Fawad149/SAR-ADC-sg13g2/digital/librelane/runs/RUN_FINAL/50-odb-reportwirelength/wire_lengths.csv

net | length_um
net33 | 156.355µm
net6 | 126.21µm
net1 | 120.975µm
clknet_0_clk | 112.86µm
_063_ | 108.015µm
net8 | 104.31µm
net14 | 100.2µm
net2 | 96.61µm
net11 | 95.785µm
net3 | 87.08µm
net12 | 79.865µm
clknet_2_2__leaf_clk | 70.425µm
rst | 70.11µm
net15 | 70.105µm
net5 | 68.985µm
net4 | 67.265µm
clknet_2_3__leaf_clk | 65.265µm
clknet_2_0__leaf_clk | 64.51µm
clk | 60.52µm
clknet_2_1__leaf_clk | 56.805µm
net13 | 56.125µm
_055_ | 53.545µm
_051_ | 53.43µm
net9 | 51.06µm
_059_ | 48.95µm
net18 | 45.74µm
net35 | 44.96µm
net17 | 44.37µm
net19 | 39.33µm
_053_ | 39.155µm
net7 | 37.465µm
net30 | 37.11µm
_066_ | 35.355µm
net16 | 35.27µm
dbit\[1\] | 34.965µm
net40 | 34.51µm
_043_ | 33.155µm
net41 | 32.695µm
net36 | 32.005µm
net27 | 31.09µm
net124 | 31.02µm
net24 | 30.745µm
net20 | 30.705µm
net42 | 29.78µm
D[11] | 29.49µm
B[7] | 29.26µm
BN[10] | 28.53µm
dbit\[0\] | 28.03µm
D[8] | 27.39µm
net37 | 27.285µm
net34 | 26.83µm
net29 | 26.77µm
net31 | 26.48µm
B[2] | 25.71µm
_036_ | 25.58µm
D[0] | 25.48µm
net28 | 25.215µm
net25 | 25.1µm
_058_ | 24.68µm
sign | 24.4µm
net53 | 24.32µm
dbit\[2\] | 24.01µm
_054_ | 23.905µm
net45 | 23.89µm
net66 | 23.76µm
_042_ | 23.235µm
net23 | 23.01µm
D[1] | 22.86µm
net38 | 22.825µm
net57 | 22.68µm
dbit\[3\] | 22.68µm
net22 | 22.485µm
net55 | 22.475µm
net92 | 22.435µm
BN[5] | 22.29µm
_030_ | 22.09µm
net84 | 22.09µm
B[10] | 21.81µm
B[8] | 21.72µm
BN[11] | 21.65µm
D[4] | 21.63µm
D[6] | 21.33µm
net103 | 21.12µm
net44 | 21.01µm
B[6] | 20.85µm
net52 | 20.83µm
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
net51 | 3µm
net128 | 3µm
net130 | 3µm
_045_ | 2.76µm
net85 | 2.73µm
_038_ | 2.66µm
net97 | 2.58µm
net102 | 2.18µm
net129 | 2.18µm
_033_ | 1.87µm
_006_ | 1.8µm
_008_ | 1.8µm
_014_ | 1.8µm
_018_ | 1.8µm
_037_ | 1.705µm
net100 | 1.7µm
net115 | 1.44µm
_034_ | 0.98µm
net89 | 0.96µm
net91 | 0.96µm
