Fawad149/SAR-ADC-sg13g2/digital/librelane/runs/RUN_FINAL/56-openroad-irdropreport/net-VGND.csv

Instance | Terminal | Layer | X location | Y location | Voltage
FILLER_17_144 | VSS | Metal1 | 75.8280 | 82.7830 | 0.000008
FILLER_17_137 | VSS | Metal1 | 73.2060 | 82.6990 | 0.000008
FILLER_17_130 | VSS | Metal1 | 69.8460 | 82.6990 | 0.000008
FILLER_17_123 | VSS | Metal1 | 66.4860 | 82.6990 | 0.000008
FILLER_17_117 | VSS | Metal1 | 62.4000 | 83.1600 | 0.000008
FILLER_17_84 | VSS | Metal1 | 46.3200 | 83.1600 | 0.000007
FILLER_17_77 | VSS | Metal1 | 44.4060 | 82.6990 | 0.000007
FILLER_17_70 | VSS | Metal1 | 41.0460 | 82.6990 | 0.000007
FILLER_17_53 | VSS | Metal1 | 31.4400 | 83.1600 | 0.000006
FILLER_17_49 | VSS | Metal1 | 30.2280 | 82.7830 | 0.000006
FILLER_17_42 | VSS | Metal1 | 27.6060 | 82.6990 | 0.000006
FILLER_17_35 | VSS | Metal1 | 24.2460 | 82.6990 | 0.000006
FILLER_17_28 | VSS | Metal1 | 20.8860 | 82.6990 | 0.000006
FILLER_17_21 | VSS | Metal1 | 17.5260 | 82.6990 | 0.000006
FILLER_17_14 | VSS | Metal1 | 14.1660 | 82.6990 | 0.000006
FILLER_17_7 | VSS | Metal1 | 10.8060 | 82.6990 | 0.000006
FILLER_17_0 | VSS | Metal1 | 7.4460 | 82.6990 | 0.000006
FILLER_16_147 | VSS | Metal1 | 76.5600 | 75.6000 | 0.000181
FILLER_16_143 | VSS | Metal1 | 75.3480 | 75.9760 | 0.000181
FILLER_16_136 | VSS | Metal1 | 72.7260 | 76.0600 | 0.000181
FILLER_16_129 | VSS | Metal1 | 69.3660 | 76.0600 | 0.000181
FILLER_16_122 | VSS | Metal1 | 66.0060 | 76.0600 | 0.000181
FILLER_16_88 | VSS | Metal1 | 48.4800 | 75.6000 | 0.000179
FILLER_16_32 | VSS | Metal1 | 21.6000 | 75.6000 | 0.000179
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
B\[2\]$_SDFFE_PP1P_ | VSS | Metal1 | 63.4650 | 67.7470 | 0.000703
B\[1\]$_SDFFE_PP1P_ | VSS | Metal1 | 15.2550 | 52.6270 | 0.000262
B\[11\]$_SDFFE_PP1P_ | VSS | Metal1 | 37.7940 | 60.1260 | 0.000152
B\[10\]$_SDFFE_PP1P_ | VSS | Metal1 | 41.3850 | 75.8920 | 0.000179
B\[0\]$_SDFFE_PP1P_ | VSS | Metal1 | 25.5450 | 15.4120 | 0.000056
BN\[9\]$_SDFFE_PP1P_ | VSS | Metal1 | 15.7350 | 68.3320 | 0.000697
BN\[8\]$_SDFFE_PP1P_ | VSS | Metal1 | 14.7750 | 29.9470 | 0.000478
BN\[7\]$_SDFFE_PP1P_ | VSS | Metal1 | 69.2250 | 52.6270 | 0.000300
BN\[6\]$_SDFFE_PP1P_ | VSS | Metal1 | 54.8250 | 68.3320 | 0.000701
BN\[5\]$_SDFFE_PP1P_ | VSS | Metal1 | 30.3450 | 75.3070 | 0.000178
BN\[4\]$_SDFFE_PP1P_ | VSS | Metal1 | 15.2550 | 45.0670 | 0.000362
BN\[3\]$_SDFFE_PP1P_ | VSS | Metal1 | 68.2650 | 37.5070 | 0.000512
BN\[2\]$_SDFFE_PP1P_ | VSS | Metal1 | 70.1850 | 60.7720 | 0.000193
BN\[1\]$_SDFFE_PP1P_ | VSS | Metal1 | 15.2550 | 53.2120 | 0.000262
BN\[11\]$_SDFFE_PP1P_ | VSS | Metal1 | 62.9850 | 29.9470 | 0.000542
BN\[10\]$_SDFFE_PP1P_ | VSS | Metal1 | 44.2650 | 67.7470 | 0.000701
BN\[0\]$_SDFFE_PP1P_ | VSS | Metal1 | 28.4250 | 22.3870 | 0.000206
