Fawad149/SAR-ADC-sg13g2/digital/librelane/runs/RUN_FINAL/56-openroad-irdropreport/net-VPWR.csv

Instance | Terminal | Layer | X location | Y location | Voltage
FILLER_17_144 | VDD | Metal1 | 75.8510 | 79.9760 | 1.199898
FILLER_17_137 | VDD | Metal1 | 73.2090 | 79.9780 | 1.199898
FILLER_17_130 | VDD | Metal1 | 69.8490 | 79.9780 | 1.199898
FILLER_17_123 | VDD | Metal1 | 66.4890 | 79.9780 | 1.199898
FILLER_17_117 | VDD | Metal1 | 62.4000 | 79.3800 | 1.199898
FILLER_17_84 | VDD | Metal1 | 46.3200 | 79.3800 | 1.199900
FILLER_17_77 | VDD | Metal1 | 44.4090 | 79.9780 | 1.199900
FILLER_17_70 | VDD | Metal1 | 41.0490 | 79.9780 | 1.199900
FILLER_17_53 | VDD | Metal1 | 31.4400 | 79.3800 | 1.199901
FILLER_17_49 | VDD | Metal1 | 30.2510 | 79.9760 | 1.199902
FILLER_17_42 | VDD | Metal1 | 27.6090 | 79.9780 | 1.199929
FILLER_17_35 | VDD | Metal1 | 24.2490 | 79.9780 | 1.199930
FILLER_17_28 | VDD | Metal1 | 20.8890 | 79.9780 | 1.199930
FILLER_17_21 | VDD | Metal1 | 17.5290 | 79.9780 | 1.199936
FILLER_17_14 | VDD | Metal1 | 14.1690 | 79.9780 | 1.199936
FILLER_17_7 | VDD | Metal1 | 10.8090 | 79.9780 | 1.199936
FILLER_17_0 | VDD | Metal1 | 7.4490 | 79.9780 | 1.199936
FILLER_16_147 | VDD | Metal1 | 76.5600 | 79.3800 | 1.199898
FILLER_16_143 | VDD | Metal1 | 75.3710 | 78.7830 | 1.199898
FILLER_16_136 | VDD | Metal1 | 72.7290 | 78.7810 | 1.199898
FILLER_16_129 | VDD | Metal1 | 69.3690 | 78.7810 | 1.199898
FILLER_16_122 | VDD | Metal1 | 66.0090 | 78.7810 | 1.199898
FILLER_16_88 | VDD | Metal1 | 48.4800 | 79.3800 | 1.199899
FILLER_16_32 | VDD | Metal1 | 21.6000 | 79.3800 | 1.199930
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
B\[2\]$_SDFFE_PP1P_ | VDD | Metal1 | 63.6220 | 64.7410 | 1.199568
B\[1\]$_SDFFE_PP1P_ | VDD | Metal1 | 15.0970 | 49.6210 | 1.199613
B\[11\]$_SDFFE_PP1P_ | VDD | Metal1 | 37.3960 | 57.1870 | 1.199766
B\[10\]$_SDFFE_PP1P_ | VDD | Metal1 | 41.5420 | 78.8980 | 1.199900
B\[0\]$_SDFFE_PP1P_ | VDD | Metal1 | 25.7020 | 18.4180 | 1.199833
BN\[9\]$_SDFFE_PP1P_ | VDD | Metal1 | 15.5770 | 71.3380 | 1.199523
BN\[8\]$_SDFFE_PP1P_ | VDD | Metal1 | 14.6170 | 26.9410 | 1.199708
BN\[7\]$_SDFFE_PP1P_ | VDD | Metal1 | 69.3820 | 49.6210 | 1.199562
BN\[6\]$_SDFFE_PP1P_ | VDD | Metal1 | 54.9820 | 71.3380 | 1.199472
BN\[5\]$_SDFFE_PP1P_ | VDD | Metal1 | 30.5020 | 72.3010 | 1.199503
BN\[4\]$_SDFFE_PP1P_ | VDD | Metal1 | 15.0970 | 42.0610 | 1.199733
BN\[3\]$_SDFFE_PP1P_ | VDD | Metal1 | 68.4220 | 34.5010 | 1.199375
BN\[2\]$_SDFFE_PP1P_ | VDD | Metal1 | 70.3420 | 63.7780 | 1.199568
BN\[1\]$_SDFFE_PP1P_ | VDD | Metal1 | 15.0970 | 56.2180 | 1.199769
BN\[11\]$_SDFFE_PP1P_ | VDD | Metal1 | 63.1420 | 26.9410 | 1.199658
BN\[10\]$_SDFFE_PP1P_ | VDD | Metal1 | 44.4220 | 64.7410 | 1.199588
BN\[0\]$_SDFFE_PP1P_ | VDD | Metal1 | 28.5820 | 19.3810 | 1.199833
