Fawad149/SAR-ADC-sg13g2/verification/SAR_ADC_extracted.cir

* Extracted by KLayout with SG13G2 LVS runset on : 11/07/2026 05:27

.SUBCKT SAR_ADC gnd vref vdd clk_cmp vbias D1 D9 D0 clk_samp sign D4 D2 D5 D8
+ D3 D10 D7 D11 D6 Vinn Vinp
X$21 gnd clk_samp vdd Vinn \$211 bootstrap_switch$1
X$24 gnd clk_samp vdd Vinp \$212 bootstrap_switch
X$54 gnd vdd \$4 clk_cmp \$120 \$126 \$127 vbias dynamic_comparator_new
X$59 \$13 \$12 \$9 \$6 \$3 \$26 vref \$91 \$89 \$87 \$92 \$88 \$90 \$120 cdac$2
X$78 \$22 \$18 \$11 \$10 \$5 \$35 vref \$82 \$81 \$80 \$85 \$84 \$83 \$4 cdac
X$100 gnd \$17 D1 \$127 \$126 vdd \$23 \$20 \$14 clk_cmp \$98 \$49 \$58 D0
+ clk_samp sign D4 \$71 D9 D8 \$21 \$19 \$8 D5 \$99 \$45 \$60 D2 \$16 D3 \$15
+ D10 \$42 \$43 \$41 D7 D6 \$7 \$206 \$76 \$72 \$24 D11 sar_logic
X$112 \$7 \$8 \$14 \$15 \$16 \$23 gnd vref \$26 \$13 \$12 \$9 \$6 \$3 vdd \$71
+ \$72 \$42 \$98 \$99 \$41 \$92 \$88 \$90 \$91 \$89 \$87 switch_array_new$2
X$128 \$24 \$21 \$20 \$19 \$45 \$17 gnd vref \$35 \$22 \$18 \$11 \$10 \$5 vdd
+ \$58 \$206 \$43 \$49 \$60 \$76 \$85 \$84 \$83 \$82 \$81 \$80 switch_array_new
.ENDS SAR_ADC

.SUBCKT switch_array_new D5 D4 D3 D2 D1 D0 gnd Vref S5 S4 S3 S2 S1 S0 vdd D_MSB
+ D10 D9 D8 D7 D6 S_MSB S10 S9 S8 S7 S6
M$1 Vref D5 S5 gnd sg13_lv_nmos L=0.13u W=2u AS=0.68p AD=0.68p PS=4.68u PD=4.68u
M$2 Vref D4 S4 gnd sg13_lv_nmos L=0.13u W=2u AS=0.68p AD=0.68p PS=4.68u PD=4.68u
M$3 Vref D3 S3 gnd sg13_lv_nmos L=0.13u W=2u AS=0.68p AD=0.68p PS=4.68u PD=4.68u
M$4 Vref D2 S2 gnd sg13_lv_nmos L=0.13u W=2u AS=0.68p AD=0.68p PS=4.68u PD=4.68u
M$5 Vref D1 S1 gnd sg13_lv_nmos L=0.13u W=2u AS=0.68p AD=0.68p PS=4.68u PD=4.68u
M$6 Vref D0 S0 gnd sg13_lv_nmos L=0.13u W=2u AS=0.68p AD=0.68p PS=4.68u PD=4.68u
M$7 gnd \$110 S7 gnd sg13_lv_nmos L=0.13u W=2u AS=0.68p AD=0.68p PS=4.68u
+ PD=4.68u
M$8 gnd \$109 S8 gnd sg13_lv_nmos L=0.13u W=2u AS=0.68p AD=0.68p PS=4.68u
+ PD=4.68u
M$9 gnd \$108 S9 gnd sg13_lv_nmos L=0.13u W=2u AS=0.68p AD=0.68p PS=4.68u
+ PD=4.68u
M$10 gnd \$111 S6 gnd sg13_lv_nmos L=0.13u W=2u AS=0.68p AD=0.68p PS=4.68u
+ PD=4.68u
M$11 gnd \$25 S2 gnd sg13_lv_nmos L=0.13u W=2u AS=0.68p AD=0.68p PS=4.68u
+ PD=4.68u
M$12 gnd \$23 S4 gnd sg13_lv_nmos L=0.13u W=2u AS=0.68p AD=0.68p PS=4.68u
+ PD=4.68u
M$13 gnd \$21 S5 gnd sg13_lv_nmos L=0.13u W=2u AS=0.68p AD=0.68p PS=4.68u
+ PD=4.68u
M$14 gnd \$24 S3 gnd sg13_lv_nmos L=0.13u W=2u AS=0.68p AD=0.68p PS=4.68u
+ PD=4.68u
M$15 gnd \$106 S_MSB gnd sg13_lv_nmos L=0.13u W=2u AS=0.68p AD=0.68p PS=4.68u
+ PD=4.68u
M$16 gnd \$26 S1 gnd sg13_lv_nmos L=0.13u W=2u AS=0.68p AD=0.68p PS=4.68u
+ PD=4.68u
M$17 gnd \$107 S10 gnd sg13_lv_nmos L=0.13u W=2u AS=0.68p AD=0.68p PS=4.68u
+ PD=4.68u
M$18 gnd \$27 S0 gnd sg13_lv_nmos L=0.13u W=2u AS=0.68p AD=0.68p PS=4.68u
+ PD=4.68u
M$19 Vref D6 S6 gnd sg13_lv_nmos L=0.13u W=2u AS=0.68p AD=0.68p PS=4.68u
+ PD=4.68u
M$20 Vref D7 S7 gnd sg13_lv_nmos L=0.13u W=2u AS=0.68p AD=0.68p PS=4.68u
+ PD=4.68u
M$21 Vref D8 S8 gnd sg13_lv_nmos L=0.13u W=2u AS=0.68p AD=0.68p PS=4.68u
+ PD=4.68u
M$22 Vref D9 S9 gnd sg13_lv_nmos L=0.13u W=2u AS=0.68p AD=0.68p PS=4.68u
+ PD=4.68u
M$23 Vref D10 S10 gnd sg13_lv_nmos L=0.13u W=2u AS=0.68p AD=0.68p PS=4.68u
+ PD=4.68u
M$24 Vref D_MSB S_MSB gnd sg13_lv_nmos L=0.13u W=2u AS=0.68p AD=0.68p PS=4.68u
+ PD=4.68u
M$25 gnd D5 S5 vdd sg13_lv_pmos L=0.13u W=4u AS=1.36p AD=1.36p PS=8.68u PD=8.68u
M$26 gnd D4 S4 vdd sg13_lv_pmos L=0.13u W=4u AS=1.36p AD=1.36p PS=8.68u PD=8.68u
M$27 gnd D3 S3 vdd sg13_lv_pmos L=0.13u W=4u AS=1.36p AD=1.36p PS=8.68u PD=8.68u
M$28 gnd D2 S2 vdd sg13_lv_pmos L=0.13u W=4u AS=1.36p AD=1.36p PS=8.68u PD=8.68u
M$29 gnd D1 S1 vdd sg13_lv_pmos L=0.13u W=4u AS=1.36p AD=1.36p PS=8.68u PD=8.68u
M$30 gnd D0 S0 vdd sg13_lv_pmos L=0.13u W=4u AS=1.36p AD=1.36p PS=8.68u PD=8.68u
M$31 gnd D7 S7 vdd sg13_lv_pmos L=0.13u W=4u AS=1.36p AD=1.36p PS=8.68u PD=8.68u
M$32 gnd D8 S8 vdd sg13_lv_pmos L=0.13u W=4u AS=1.36p AD=1.36p PS=8.68u PD=8.68u
M$33 gnd D6 S6 vdd sg13_lv_pmos L=0.13u W=4u AS=1.36p AD=1.36p PS=8.68u PD=8.68u
M$34 gnd D9 S9 vdd sg13_lv_pmos L=0.13u W=4u AS=1.36p AD=1.36p PS=8.68u PD=8.68u
M$35 gnd D10 S10 vdd sg13_lv_pmos L=0.13u W=4u AS=1.36p AD=1.36p PS=8.68u
+ PD=8.68u
M$36 gnd D_MSB S_MSB vdd sg13_lv_pmos L=0.13u W=4u AS=1.36p AD=1.36p PS=8.68u
+ PD=8.68u
M$37 Vref \$21 S5 vdd sg13_lv_pmos L=0.13u W=4u AS=1.36p AD=1.36p PS=8.68u
+ PD=8.68u
M$38 Vref \$24 S3 vdd sg13_lv_pmos L=0.13u W=4u AS=1.36p AD=1.36p PS=8.68u
+ PD=8.68u
M$39 Vref \$26 S1 vdd sg13_lv_pmos L=0.13u W=4u AS=1.36p AD=1.36p PS=8.68u
+ PD=8.68u
M$40 Vref \$27 S0 vdd sg13_lv_pmos L=0.13u W=4u AS=1.36p AD=1.36p PS=8.68u
+ PD=8.68u
M$41 Vref \$110 S7 vdd sg13_lv_pmos L=0.13u W=4u AS=1.36p AD=1.36p PS=8.68u
+ PD=8.68u
M$42 Vref \$107 S10 vdd sg13_lv_pmos L=0.13u W=4u AS=1.36p AD=1.36p PS=8.68u
+ PD=8.68u
M$43 Vref \$106 S_MSB vdd sg13_lv_pmos L=0.13u W=4u AS=1.36p AD=1.36p PS=8.68u
+ PD=8.68u
M$44 Vref \$108 S9 vdd sg13_lv_pmos L=0.13u W=4u AS=1.36p AD=1.36p PS=8.68u
+ PD=8.68u
M$45 Vref \$109 S8 vdd sg13_lv_pmos L=0.13u W=4u AS=1.36p AD=1.36p PS=8.68u
+ PD=8.68u
M$46 Vref \$111 S6 vdd sg13_lv_pmos L=0.13u W=4u AS=1.36p AD=1.36p PS=8.68u
+ PD=8.68u
M$47 Vref \$25 S2 vdd sg13_lv_pmos L=0.13u W=4u AS=1.36p AD=1.36p PS=8.68u
+ PD=8.68u
M$48 Vref \$23 S4 vdd sg13_lv_pmos L=0.13u W=4u AS=1.36p AD=1.36p PS=8.68u
+ PD=8.68u
M$49 gnd D5 \$21 gnd sg13_lv_nmos L=0.13u W=0.4u AS=0.136p AD=0.136p PS=1.48u
+ PD=1.48u
M$50 gnd D4 \$23 gnd sg13_lv_nmos L=0.13u W=0.4u AS=0.136p AD=0.136p PS=1.48u
+ PD=1.48u
M$51 gnd D3 \$24 gnd sg13_lv_nmos L=0.13u W=0.4u AS=0.136p AD=0.136p PS=1.48u
+ PD=1.48u
M$52 gnd D2 \$25 gnd sg13_lv_nmos L=0.13u W=0.4u AS=0.136p AD=0.136p PS=1.48u
+ PD=1.48u
M$53 gnd D1 \$26 gnd sg13_lv_nmos L=0.13u W=0.4u AS=0.136p AD=0.136p PS=1.48u
+ PD=1.48u
M$54 gnd D0 \$27 gnd sg13_lv_nmos L=0.13u W=0.4u AS=0.136p AD=0.136p PS=1.48u
+ PD=1.48u
M$55 gnd D6 \$111 gnd sg13_lv_nmos L=0.13u W=0.4u AS=0.136p AD=0.136p PS=1.48u
+ PD=1.48u
M$56 gnd D9 \$108 gnd sg13_lv_nmos L=0.13u W=0.4u AS=0.136p AD=0.136p PS=1.48u
+ PD=1.48u
M$57 gnd D7 \$110 gnd sg13_lv_nmos L=0.13u W=0.4u AS=0.136p AD=0.136p PS=1.48u
+ PD=1.48u
M$58 gnd D_MSB \$106 gnd sg13_lv_nmos L=0.13u W=0.4u AS=0.136p AD=0.136p
+ PS=1.48u PD=1.48u
M$59 gnd D10 \$107 gnd sg13_lv_nmos L=0.13u W=0.4u AS=0.136p AD=0.136p PS=1.48u
+ PD=1.48u
M$60 gnd D8 \$109 gnd sg13_lv_nmos L=0.13u W=0.4u AS=0.136p AD=0.136p PS=1.48u
+ PD=1.48u
M$61 vdd D5 \$21 vdd sg13_lv_pmos L=0.13u W=0.8u AS=0.272p AD=0.272p PS=2.28u
+ PD=2.28u
M$62 vdd D4 \$23 vdd sg13_lv_pmos L=0.13u W=0.8u AS=0.272p AD=0.272p PS=2.28u
+ PD=2.28u
M$63 vdd D3 \$24 vdd sg13_lv_pmos L=0.13u W=0.8u AS=0.272p AD=0.272p PS=2.28u
+ PD=2.28u
M$64 vdd D2 \$25 vdd sg13_lv_pmos L=0.13u W=0.8u AS=0.272p AD=0.272p PS=2.28u
+ PD=2.28u
M$65 vdd D1 \$26 vdd sg13_lv_pmos L=0.13u W=0.8u AS=0.272p AD=0.272p PS=2.28u
+ PD=2.28u
M$66 vdd D0 \$27 vdd sg13_lv_pmos L=0.13u W=0.8u AS=0.272p AD=0.272p PS=2.28u
+ PD=2.28u
M$67 vdd D6 \$111 vdd sg13_lv_pmos L=0.13u W=0.8u AS=0.272p AD=0.272p PS=2.28u
+ PD=2.28u
M$68 vdd D7 \$110 vdd sg13_lv_pmos L=0.13u W=0.8u AS=0.272p AD=0.272p PS=2.28u
+ PD=2.28u
M$69 vdd D8 \$109 vdd sg13_lv_pmos L=0.13u W=0.8u AS=0.272p AD=0.272p PS=2.28u
+ PD=2.28u
M$70 vdd D9 \$108 vdd sg13_lv_pmos L=0.13u W=0.8u AS=0.272p AD=0.272p PS=2.28u
+ PD=2.28u
M$71 vdd D10 \$107 vdd sg13_lv_pmos L=0.13u W=0.8u AS=0.272p AD=0.272p PS=2.28u
+ PD=2.28u
M$72 vdd D_MSB \$106 vdd sg13_lv_pmos L=0.13u W=0.8u AS=0.272p AD=0.272p
+ PS=2.28u PD=2.28u
.ENDS switch_array_new

.SUBCKT dynamic_comparator_new gnd vdd Vplus clk Vminus out_plus out_minus vbias
R$1 \$4 gnd rppd w=2.5u l=18.02u ps=0.18u b=6 m=1
R$2 gnd \$6 rppd w=2.5u l=18.02u ps=0.18u b=6 m=1
M$3 \$22 Vminus \$4 vdd sg13_lv_pmos L=0.3u W=8u AS=2.72p AD=2.72p PS=16.68u
+ PD=16.68u
M$4 \$6 Vplus \$22 vdd sg13_lv_pmos L=0.3u W=8u AS=2.72p AD=2.72p PS=16.68u
+ PD=16.68u
M$5 vdd vbias \$22 vdd sg13_lv_pmos L=0.8u W=12u AS=4.08p AD=4.08p PS=24.68u
+ PD=24.68u
M$6 \$10 \$6 \$5 vdd sg13_lv_pmos L=0.3u W=32u AS=7.28p AD=7.28p PS=41.82u
+ PD=41.82u
M$10 \$10 \$4 \$13 vdd sg13_lv_pmos L=0.3u W=32u AS=7.28p AD=7.28p PS=41.82u
+ PD=41.82u
M$14 out_minus \$5 vdd vdd sg13_lv_pmos L=0.2u W=8u AS=2.72p AD=2.72p PS=16.68u
+ PD=16.68u
M$15 out_plus \$13 vdd vdd sg13_lv_pmos L=0.2u W=8u AS=2.72p AD=2.72p PS=16.68u
+ PD=16.68u
M$16 \$13 \$5 gnd gnd sg13_lv_nmos L=0.2u W=4u AS=1.36p AD=1.36p PS=8.68u
+ PD=8.68u
M$17 \$5 clk gnd gnd sg13_lv_nmos L=0.2u W=4u AS=1.36p AD=1.36p PS=8.68u
+ PD=8.68u
M$18 \$5 \$13 gnd gnd sg13_lv_nmos L=0.2u W=4u AS=1.36p AD=1.36p PS=8.68u
+ PD=8.68u
M$19 \$13 clk gnd gnd sg13_lv_nmos L=0.2u W=4u AS=1.36p AD=1.36p PS=8.68u
+ PD=8.68u
M$20 gnd \$13 out_plus gnd sg13_lv_nmos L=0.2u W=4u AS=1.36p AD=1.36p PS=8.68u
+ PD=8.68u
M$21 gnd \$5 out_minus gnd sg13_lv_nmos L=0.2u W=4u AS=1.36p AD=1.36p PS=8.68u
+ PD=8.68u
M$22 vdd vbias \$43 vdd sg13_lv_pmos L=0.3u W=18u AS=4.095p AD=4.095p PS=24.32u
+ PD=24.32u
M$26 \$43 clk \$10 vdd sg13_lv_pmos L=0.3u W=18u AS=4.095p AD=4.095p PS=24.32u
+ PD=24.32u
.ENDS dynamic_comparator_new

.SUBCKT bootstrap_switch gnd clk vdd vi vo
M$1 gnd \$3 \$29 gnd sg13_lv_nmos L=0.2u W=1.3u AS=0.442p AD=0.442p PS=3.28u
+ PD=3.28u
M$2 \$15 vdd \$23 gnd sg13_lv_nmos L=0.13u W=3u AS=1.02p AD=1.02p PS=6.68u
+ PD=6.68u
M$3 \$15 \$3 gnd gnd sg13_lv_nmos L=0.13u W=3u AS=1.02p AD=1.02p PS=6.68u
+ PD=6.68u
M$4 vi \$23 \$29 gnd sg13_lv_nmos L=0.25u W=3.5u AS=1.19p AD=1.19p PS=7.68u
+ PD=7.68u
M$5 vi \$3 vi gnd sg13_lv_nmos L=0.13u W=1.5u AS=0.51p AD=0.51p PS=3.68u
+ PD=3.68u
M$6 vo \$3 vo gnd sg13_lv_nmos L=0.13u W=1.5u AS=0.51p AD=0.51p PS=3.68u
+ PD=3.68u
M$7 vo \$25 vi gnd sg13_lv_nmos L=0.25u W=6u AS=2.04p AD=2.04p PS=12.68u
+ PD=12.68u
M$8 vdd \$18 \$19 gnd sg13_lv_nmos L=0.13u W=1.3u AS=0.442p AD=0.442p PS=3.28u
+ PD=3.28u
M$9 vdd \$19 \$22 gnd sg13_lv_nmos L=0.13u W=1.3u AS=0.442p AD=0.442p PS=3.28u
+ PD=3.28u
M$10 vdd \$19 \$18 gnd sg13_lv_nmos L=0.13u W=1.3u AS=0.442p AD=0.442p PS=3.28u
+ PD=3.28u
C$11 \$22 \$29 cap_cmim w=11.485u l=11.485u A=131.905225p P=45.94u m=1
C$12 \$19 \$3 cap_cmim w=4.665u l=6.99u A=32.60835p P=23.31u m=1
C$13 \$18 \$12 cap_cmim w=4.665u l=6.99u A=32.60835p P=23.31u m=1
M$14 \$23 \$35 vdd vdd sg13_lv_pmos L=0.13u W=0.5u AS=0.17p AD=0.17p PS=1.68u
+ PD=1.68u
M$15 \$22 \$50 \$25 \$22 sg13_lv_pmos L=0.13u W=0.5u AS=0.17p AD=0.17p PS=1.68u
+ PD=1.68u
M$16 \$36 \$3 gnd gnd sg13_lv_nmos L=0.13u W=0.5u AS=0.17p AD=0.17p PS=1.68u
+ PD=1.68u
M$17 \$25 vdd \$36 gnd sg13_lv_nmos L=0.13u W=0.5u AS=0.17p AD=0.17p PS=1.68u
+ PD=1.68u
M$18 vdd clk \$3 vdd sg13_lv_pmos L=0.13u W=0.8u AS=0.272p AD=0.272p PS=2.28u
+ PD=2.28u
M$19 vdd \$35 \$50 vdd sg13_lv_pmos L=0.13u W=0.8u AS=0.272p AD=0.272p PS=2.28u
+ PD=2.28u
M$20 vdd \$3 \$12 vdd sg13_lv_pmos L=0.13u W=0.8u AS=0.272p AD=0.272p PS=2.28u
+ PD=2.28u
M$21 gnd clk \$3 gnd sg13_lv_nmos L=0.13u W=0.4u AS=0.136p AD=0.136p PS=1.48u
+ PD=1.48u
M$22 gnd \$3 \$12 gnd sg13_lv_nmos L=0.13u W=0.4u AS=0.136p AD=0.136p PS=1.48u
+ PD=1.48u
M$23 gnd \$35 \$50 gnd sg13_lv_nmos L=0.13u W=0.4u AS=0.136p AD=0.136p PS=1.48u
+ PD=1.48u
.ENDS bootstrap_switch

.SUBCKT bootstrap_switch$1 gnd clk vdd vi vo
M$1 gnd \$3 \$29 gnd sg13_lv_nmos L=0.2u W=1.3u AS=0.442p AD=0.442p PS=3.28u
+ PD=3.28u
M$2 \$15 vdd \$23 gnd sg13_lv_nmos L=0.13u W=3u AS=1.02p AD=1.02p PS=6.68u
+ PD=6.68u
M$3 \$15 \$3 gnd gnd sg13_lv_nmos L=0.13u W=3u AS=1.02p AD=1.02p PS=6.68u
+ PD=6.68u
M$4 vi \$23 \$29 gnd sg13_lv_nmos L=0.25u W=3.5u AS=1.19p AD=1.19p PS=7.68u
+ PD=7.68u
M$5 vi \$3 vi gnd sg13_lv_nmos L=0.13u W=1.5u AS=0.51p AD=0.51p PS=3.68u
+ PD=3.68u
M$6 vo \$3 vo gnd sg13_lv_nmos L=0.13u W=1.5u AS=0.51p AD=0.51p PS=3.68u
+ PD=3.68u
M$7 vo \$25 vi gnd sg13_lv_nmos L=0.25u W=6u AS=2.04p AD=2.04p PS=12.68u
+ PD=12.68u
M$8 vdd \$18 \$19 gnd sg13_lv_nmos L=0.13u W=1.3u AS=0.442p AD=0.442p PS=3.28u
+ PD=3.28u
M$9 vdd \$19 \$22 gnd sg13_lv_nmos L=0.13u W=1.3u AS=0.442p AD=0.442p PS=3.28u
+ PD=3.28u
M$10 vdd \$19 \$18 gnd sg13_lv_nmos L=0.13u W=1.3u AS=0.442p AD=0.442p PS=3.28u
+ PD=3.28u
C$11 \$22 \$29 cap_cmim w=11.485u l=11.485u A=131.905225p P=45.94u m=1
C$12 \$19 \$3 cap_cmim w=4.665u l=6.99u A=32.60835p P=23.31u m=1
C$13 \$18 \$12 cap_cmim w=4.665u l=6.99u A=32.60835p P=23.31u m=1
M$14 \$23 \$35 vdd vdd sg13_lv_pmos L=0.13u W=0.5u AS=0.17p AD=0.17p PS=1.68u
+ PD=1.68u
M$15 \$22 \$50 \$25 \$22 sg13_lv_pmos L=0.13u W=0.5u AS=0.17p AD=0.17p PS=1.68u
+ PD=1.68u
M$16 \$36 \$3 gnd gnd sg13_lv_nmos L=0.13u W=0.5u AS=0.17p AD=0.17p PS=1.68u
+ PD=1.68u
M$17 \$25 vdd \$36 gnd sg13_lv_nmos L=0.13u W=0.5u AS=0.17p AD=0.17p PS=1.68u
+ PD=1.68u
M$18 vdd clk \$3 vdd sg13_lv_pmos L=0.13u W=0.8u AS=0.272p AD=0.272p PS=2.28u
+ PD=2.28u
M$19 vdd \$35 \$50 vdd sg13_lv_pmos L=0.13u W=0.8u AS=0.272p AD=0.272p PS=2.28u
+ PD=2.28u
M$20 vdd \$3 \$12 vdd sg13_lv_pmos L=0.13u W=0.8u AS=0.272p AD=0.272p PS=2.28u
+ PD=2.28u
M$21 gnd clk \$3 gnd sg13_lv_nmos L=0.13u W=0.4u AS=0.136p AD=0.136p PS=1.48u
+ PD=1.48u
M$22 gnd \$3 \$12 gnd sg13_lv_nmos L=0.13u W=0.4u AS=0.136p AD=0.136p PS=1.48u
+ PD=1.48u
M$23 gnd \$35 \$50 gnd sg13_lv_nmos L=0.13u W=0.4u AS=0.136p AD=0.136p PS=1.48u
+ PD=1.48u
.ENDS bootstrap_switch$1

.SUBCKT sar_logic VGND B[0] D[1] Om Op VPWR BN[0] B[3] BN[3] clk BN[8] B[8]
+ B[11] D[0] rst sign D[4] BN[11] D[9] D[8] B[4] B[2] BN[4] D[5] BN[7] B[1]
+ B[7] D[2] BN[1] D[3] BN[2] D[10] BN[9] B[9] BN[6] D[7] D[6] BN[5] B[10] B[6]
+ BN[10] B[5] D[11]
M$1 \$I4110 \$198 VGND VGND sg13_lv_nmos L=0.13u W=0.55u AS=0.187p AD=0.1045p
+ PS=1.78u PD=0.93u
M$2 VGND \$63 \$I4110 VGND sg13_lv_nmos L=0.13u W=0.55u AS=0.1045p AD=0.198p
+ PS=0.93u PD=1.27u
M$3 \$I4110 \$228 VGND VGND sg13_lv_nmos L=0.13u W=0.55u AS=0.198p AD=0.13395p
+ PS=1.27u PD=1.12u
M$4 VGND \$I4110 \$230 VGND sg13_lv_nmos L=0.13u W=0.74u AS=0.13395p AD=0.2516p
+ PS=1.12u PD=2.16u
M$5 \$I4110 \$198 \$I4112 VPWR sg13_lv_pmos L=0.13u W=1u AS=0.34p AD=0.19p
+ PS=2.68u PD=1.38u
M$6 \$I4112 \$63 \$I4111 VPWR sg13_lv_pmos L=0.13u W=1u AS=0.19p AD=0.1575p
+ PS=1.38u PD=1.315u
M$7 \$I4111 \$228 VPWR VPWR sg13_lv_pmos L=0.13u W=1u AS=0.1575p AD=0.3822p
+ PS=1.315u PD=1.84u
M$8 VPWR \$I4110 \$230 VPWR sg13_lv_pmos L=0.13u W=1.12u AS=0.3822p AD=0.3808p
+ PS=1.84u PD=2.92u
M$9 VGND \$90 \$I4113 VGND sg13_lv_nmos L=0.13u W=0.55u AS=0.187p AD=0.1045p
+ PS=1.78u PD=0.93u
M$10 \$I4113 \$64 VGND VGND sg13_lv_nmos L=0.13u W=0.55u AS=0.1045p AD=0.1469p
+ PS=0.93u PD=1.155u
M$11 VGND \$I4113 \$94 VGND sg13_lv_nmos L=0.13u W=0.74u AS=0.1469p AD=0.2516p
+ PS=1.155u PD=2.16u
M$12 \$I4113 \$90 \$I4114 VPWR sg13_lv_pmos L=0.13u W=0.84u AS=0.2856p
+ AD=0.1596p PS=2.36u PD=1.22u
M$13 VPWR \$64 \$I4114 VPWR sg13_lv_pmos L=0.13u W=0.84u AS=0.2226p AD=0.1596p
+ PS=1.535u PD=1.22u
M$14 VPWR \$I4113 \$94 VPWR sg13_lv_pmos L=0.13u W=1.12u AS=0.2226p AD=0.3976p
+ PS=1.535u PD=2.95u
M$15 VGND \$195 \$I4115 VGND sg13_lv_nmos L=0.13u W=0.55u AS=0.187p AD=0.1045p
+ PS=1.78u PD=0.93u
M$16 \$I4115 \$43 VGND VGND sg13_lv_nmos L=0.13u W=0.55u AS=0.1045p AD=0.1469p
+ PS=0.93u PD=1.155u
M$17 VGND \$I4115 \$228 VGND sg13_lv_nmos L=0.13u W=0.74u AS=0.1469p AD=0.2516p
+ PS=1.155u PD=2.16u
M$18 \$I4115 \$195 \$I4116 VPWR sg13_lv_pmos L=0.13u W=0.84u AS=0.2856p
+ AD=0.1596p PS=2.36u PD=1.22u
M$19 VPWR \$43 \$I4116 VPWR sg13_lv_pmos L=0.13u W=0.84u AS=0.2226p AD=0.1596p
+ PS=1.535u PD=1.22u
M$20 VPWR \$I4115 \$228 VPWR sg13_lv_pmos L=0.13u W=1.12u AS=0.2226p AD=0.3976p
+ PS=1.535u PD=2.95u
M$21 VGND \$18 \$431 VGND sg13_lv_nmos L=0.13u W=1.48u AS=0.3922p AD=0.2812p
+ PS=3.28u PD=2.24u
M$23 VGND \$317 \$431 VGND sg13_lv_nmos L=0.13u W=1.48u AS=0.2812p AD=0.3922p
+ PS=2.24u PD=3.28u
M$25 \$I4117 \$18 VPWR VPWR sg13_lv_pmos L=0.13u W=2.24u AS=0.616p AD=0.4256p
+ PS=4.46u PD=3u
M$27 \$I4117 \$317 \$431 VPWR sg13_lv_pmos L=0.13u W=2.24u AS=0.4256p
+ AD=0.5936p PS=3u PD=4.42u
M$29 VGND \$43 \$136 VGND sg13_lv_nmos L=0.13u W=1.48u AS=0.3922p AD=0.2812p
+ PS=3.28u PD=2.24u
M$31 VGND \$195 \$136 VGND sg13_lv_nmos L=0.13u W=1.48u AS=0.2812p AD=0.3922p
+ PS=2.24u PD=3.28u
M$33 \$I4118 \$43 VPWR VPWR sg13_lv_pmos L=0.13u W=2.24u AS=0.616p AD=0.4256p
+ PS=4.46u PD=3u
M$35 \$I4118 \$195 \$136 VPWR sg13_lv_pmos L=0.13u W=2.24u AS=0.4256p
+ AD=0.5936p PS=3u PD=4.42u
M$37 VGND \$I4120 \$I4119 VGND sg13_lv_nmos L=0.5u W=0.42u AS=0.1426p
+ AD=0.1428p PS=1.16u PD=1.52u
M$38 VGND \$I4119 \$84 VGND sg13_lv_nmos L=0.13u W=0.74u AS=0.1426p AD=0.2516p
+ PS=1.16u PD=2.16u
M$39 \$I4121 \$18 VGND VGND sg13_lv_nmos L=0.13u W=0.42u AS=0.1428p AD=0.0798p
+ PS=1.52u PD=0.8u
M$40 VGND \$I4121 \$I4120 VGND sg13_lv_nmos L=0.5u W=0.42u AS=0.0798p
+ AD=0.1428p PS=0.8u PD=1.52u
M$41 \$I4119 \$I4120 VPWR VPWR sg13_lv_pmos L=0.5u W=1u AS=0.34p AD=0.2254p
+ PS=2.68u PD=1.53u
M$42 VPWR \$I4119 \$84 VPWR sg13_lv_pmos L=0.13u W=1.12u AS=0.2254p AD=0.4256p
+ PS=1.53u PD=3u
M$43 VPWR \$18 \$I4121 VPWR sg13_lv_pmos L=0.13u W=0.42u AS=0.1523p AD=0.1428p
+ PS=1.38u PD=1.52u
M$44 VPWR \$I4121 \$I4120 VPWR sg13_lv_pmos L=0.5u W=1u AS=0.1523p AD=0.34p
+ PS=1.38u PD=2.68u
M$45 VGND \$I4123 \$I4122 VGND sg13_lv_nmos L=0.5u W=0.42u AS=0.1426p
+ AD=0.1428p PS=1.16u PD=1.52u
M$46 VGND \$I4122 \$51 VGND sg13_lv_nmos L=0.13u W=0.74u AS=0.1426p AD=0.2516p
+ PS=1.16u PD=2.16u
M$47 \$I4124 \$75 VGND VGND sg13_lv_nmos L=0.13u W=0.42u AS=0.1428p AD=0.0798p
+ PS=1.52u PD=0.8u
M$48 VGND \$I4124 \$I4123 VGND sg13_lv_nmos L=0.5u W=0.42u AS=0.0798p
+ AD=0.1428p PS=0.8u PD=1.52u
M$49 \$I4122 \$I4123 VPWR VPWR sg13_lv_pmos L=0.5u W=1u AS=0.34p AD=0.2254p
+ PS=2.68u PD=1.53u
M$50 VPWR \$I4122 \$51 VPWR sg13_lv_pmos L=0.13u W=1.12u AS=0.2254p AD=0.4256p
+ PS=1.53u PD=3u
M$51 VPWR \$75 \$I4124 VPWR sg13_lv_pmos L=0.13u W=0.42u AS=0.1523p AD=0.1428p
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
+ AD=0.0798p PS=1.52u PD=0.8u
M$176 VGND \$I4172 \$I4171 VGND sg13_lv_nmos L=0.5u W=0.42u AS=0.0798p
+ AD=0.1428p PS=0.8u PD=1.52u
M$177 \$I4170 \$I4171 VPWR VPWR sg13_lv_pmos L=0.5u W=1u AS=0.34p AD=0.2254p
+ PS=2.68u PD=1.53u
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
