Fawad149/SAR-ADC-sg13g2/verification/switch_array_new_extracted.cir

* Extracted by KLayout with SG13G2 LVS runset on : 30/06/2026 01:40

.SUBCKT switch_array_new D5 D4 D3 D2 D1 D0 Vref gnd S5 S4 S3 S2 S1 S0 vdd D_MSB
+ D10 D9 D8 D7 D6 S_MSB S10 S9 S8 S7 S6
M$1 Vref D5 S5 gnd sg13_lv_nmos L=0.13u W=2u AS=0.68p AD=0.68p PS=4.68u PD=4.68u
M$2 Vref D4 S4 gnd sg13_lv_nmos L=0.13u W=2u AS=0.68p AD=0.68p PS=4.68u PD=4.68u
M$3 Vref D3 S3 gnd sg13_lv_nmos L=0.13u W=2u AS=0.68p AD=0.68p PS=4.68u PD=4.68u
M$4 Vref D2 S2 gnd sg13_lv_nmos L=0.13u W=2u AS=0.68p AD=0.68p PS=4.68u PD=4.68u
M$5 Vref D1 S1 gnd sg13_lv_nmos L=0.13u W=2u AS=0.68p AD=0.68p PS=4.68u PD=4.68u
M$6 Vref D0 S0 gnd sg13_lv_nmos L=0.13u W=2u AS=0.68p AD=0.68p PS=4.68u PD=4.68u
M$7 gnd D5 \$21 gnd sg13_lv_nmos L=0.13u W=0.4u AS=0.136p AD=0.136p PS=1.48u
+ PD=1.48u
M$8 gnd D4 \$22 gnd sg13_lv_nmos L=0.13u W=0.4u AS=0.136p AD=0.136p PS=1.48u
+ PD=1.48u
M$9 gnd D3 \$23 gnd sg13_lv_nmos L=0.13u W=0.4u AS=0.136p AD=0.136p PS=1.48u
+ PD=1.48u
M$10 gnd D2 \$24 gnd sg13_lv_nmos L=0.13u W=0.4u AS=0.136p AD=0.136p PS=1.48u
+ PD=1.48u
M$11 gnd D1 \$25 gnd sg13_lv_nmos L=0.13u W=0.4u AS=0.136p AD=0.136p PS=1.48u
+ PD=1.48u
M$12 gnd D0 \$26 gnd sg13_lv_nmos L=0.13u W=0.4u AS=0.136p AD=0.136p PS=1.48u
+ PD=1.48u
M$13 gnd \$21 S5 gnd sg13_lv_nmos L=0.13u W=2u AS=0.68p AD=0.68p PS=4.68u
+ PD=4.68u
M$14 gnd \$22 S4 gnd sg13_lv_nmos L=0.13u W=2u AS=0.68p AD=0.68p PS=4.68u
+ PD=4.68u
M$15 gnd \$23 S3 gnd sg13_lv_nmos L=0.13u W=2u AS=0.68p AD=0.68p PS=4.68u
+ PD=4.68u
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
+ PD=2.28u
M$64 vdd D8 \$85 vdd sg13_lv_pmos L=0.13u W=0.8u AS=0.272p AD=0.272p PS=2.28u
+ PD=2.28u
M$65 vdd D7 \$86 vdd sg13_lv_pmos L=0.13u W=0.8u AS=0.272p AD=0.272p PS=2.28u
+ PD=2.28u
M$66 vdd D6 \$87 vdd sg13_lv_pmos L=0.13u W=0.8u AS=0.272p AD=0.272p PS=2.28u
+ PD=2.28u
M$67 gnd D_MSB S_MSB vdd sg13_lv_pmos L=0.13u W=4u AS=1.36p AD=1.36p PS=8.68u
+ PD=8.68u
M$68 gnd D10 S10 vdd sg13_lv_pmos L=0.13u W=4u AS=1.36p AD=1.36p PS=8.68u
+ PD=8.68u
M$69 gnd D9 S9 vdd sg13_lv_pmos L=0.13u W=4u AS=1.36p AD=1.36p PS=8.68u PD=8.68u
M$70 gnd D8 S8 vdd sg13_lv_pmos L=0.13u W=4u AS=1.36p AD=1.36p PS=8.68u PD=8.68u
M$71 gnd D7 S7 vdd sg13_lv_pmos L=0.13u W=4u AS=1.36p AD=1.36p PS=8.68u PD=8.68u
M$72 gnd D6 S6 vdd sg13_lv_pmos L=0.13u W=4u AS=1.36p AD=1.36p PS=8.68u PD=8.68u
.ENDS switch_array_new
