Fawad149/SAR-ADC-sg13g2/digital/librelane/runs/RUN_FINAL/final/mag_gds/mag_spice/sar_logic.spice

* NGSPICE file created from sar_logic.ext - technology: ihp-sg13g2

.subckt sar_logic BN[0] BN[10] BN[11] BN[1] BN[2] BN[3] BN[4] BN[5] BN[6] BN[7] BN[8]
+ BN[9] B[0] B[10] B[11] B[1] B[2] B[3] B[4] B[5] B[6] B[7] B[8] B[9] D[0] D[10] D[11]
+ D[1] D[2] D[3] D[4] D[5] D[6] D[7] D[8] D[9] sign Om Op VGND VPWR clk rst 
X0 _032_ net6 VPWR VPWR sg13_lv_pmos ad=0.2128p pd=1.5u as=0.3808p ps=2.92u w=1.12u l=0.13u
X1 VPWR net1 _032_ VPWR sg13_lv_pmos ad=0.2128p pd=1.5u as=0.2128p ps=1.5u w=1.12u l=0.13u
X2 _032_ _055_ VPWR VPWR sg13_lv_pmos ad=0.3808p pd=2.92u as=0.2128p ps=1.5u w=1.12u l=0.13u
X3 _131_/a_146_122# net6 VGND VGND sg13_lv_nmos ad=0.1406p pd=1.12u as=0.2886p ps=2.26u w=0.74u l=0.13u
X4 _131_/a_248_122# net1 _131_/a_146_122# VGND sg13_lv_nmos ad=0.1406p pd=1.12u as=0.1406p ps=1.12u w=0.74u l=0.13u
X5 _032_ _055_ _131_/a_248_122# VGND sg13_lv_nmos ad=0.2516p pd=2.16u as=0.1406p ps=1.12u w=0.74u l=0.13u
X6 net75 dbit\[3\]$_SDFFE_PP1P__59/a_222_366# VPWR VPWR sg13_lv_pmos ad=0.3927p pd=2.99u as=0.76727p ps=3.885u w=1.155u l=0.13u
X7 VPWR dbit\[3\]$_SDFFE_PP1P__59/a_23_195# dbit\[3\]$_SDFFE_PP1P__59/a_23_429# VPWR sg13_lv_pmos ad=0.76727p pd=3.885u as=0.2442p ps=2.06u w=0.66u l=0.13u
X8 dbit\[3\]$_SDFFE_PP1P__59/a_222_366# dbit\[3\]$_SDFFE_PP1P__59/a_23_429# VGND VGND sg13_lv_nmos ad=0.27427p pd=2.28u as=0.49637p ps=3.565u w=0.795u l=0.13u
X9 VGND dbit\[3\]$_SDFFE_PP1P__59/a_23_195# dbit\[3\]$_SDFFE_PP1P__59/a_23_195# VGND sg13_lv_nmos ad=0.49637p pd=3.565u as=0.111p ps=1.34u w=0.3u l=0.13u
X10 VPWR VGND VPWR VPWR sg13_lv_pmos ad=0.34p pd=2.68u as=0.54708n ps=2.85085m w=1u l=1u M=92
X11 VGND VPWR VGND VGND sg13_lv_nmos ad=0.1428p pd=1.52u as=0.49238n ps=2.62321m w=0.42u l=1u M=92
X12 VPWR _011_ hold30/a_56_118# VPWR sg13_lv_pmos ad=0.1523p pd=1.38u as=0.1428p ps=1.52u w=0.42u l=0.13u
X13 VGND hold30/a_326_118# hold30/a_438_182# VGND sg13_lv_nmos ad=0.1426p pd=1.16u as=0.1428p ps=1.52u w=0.42u l=0.5u
X14 VPWR hold30/a_326_118# hold30/a_438_182# VPWR sg13_lv_pmos ad=0.2254p pd=1.53u as=0.34p ps=2.68u w=1u l=0.5u
X15 net113 hold30/a_438_182# VPWR VPWR sg13_lv_pmos ad=0.4256p pd=3u as=0.2254p ps=1.53u w=1.12u l=0.13u
X16 hold30/a_326_118# hold30/a_56_118# VPWR VPWR sg13_lv_pmos ad=0.34p pd=2.68u as=0.1523p ps=1.38u w=1u l=0.5u
X17 VGND _011_ hold30/a_56_118# VGND sg13_lv_nmos ad=79.8f pd=0.8u as=0.1428p ps=1.52u w=0.42u l=0.13u
X18 net113 hold30/a_438_182# VGND VGND sg13_lv_nmos ad=0.2516p pd=2.16u as=0.1426p ps=1.16u w=0.74u l=0.13u
X19 hold30/a_326_118# hold30/a_56_118# VGND VGND sg13_lv_nmos ad=0.1428p pd=1.52u as=79.8f ps=0.8u w=0.42u l=0.5u
X20 net7 fanout7/a_40_152# VGND VGND sg13_lv_nmos ad=0.2886p pd=2.26u as=0.14875p ps=1.16u w=0.74u l=0.13u
X21 net7 fanout7/a_40_152# VPWR VPWR sg13_lv_pmos ad=0.42p pd=2.99u as=0.2114p ps=1.54u w=1.12u l=0.13u
X22 VPWR _030_ fanout7/a_40_152# VPWR sg13_lv_pmos ad=0.2114p pd=1.54u as=0.2856p ps=2.36u w=0.84u l=0.13u
X23 VGND _030_ fanout7/a_40_152# VGND sg13_lv_nmos ad=0.14875p pd=1.16u as=0.187p ps=1.78u w=0.55u l=0.13u
X24 VGND _114_/a_115_308# _005_ VGND sg13_lv_nmos ad=0.15745p pd=1.175u as=0.2351p ps=2.16u w=0.74u l=0.13u
X25 VPWR net92 _114_/a_358_436# VPWR sg13_lv_pmos ad=0.19p pd=1.38u as=0.2125p ps=1.425u w=1u l=0.13u
X26 VGND _062_ _114_/a_494_160# VGND sg13_lv_nmos ad=0.2176p pd=1.96u as=81.6f ps=0.895u w=0.64u l=0.13u
X27 _114_/a_358_436# _062_ VPWR VPWR sg13_lv_pmos ad=0.34p pd=2.68u as=0.19p ps=1.38u w=1u l=0.13u
X28 _114_/a_115_308# net14 VGND VGND sg13_lv_nmos ad=0.1216p pd=1.02u as=0.15745p ps=1.175u w=0.64u l=0.13u
X29 _114_/a_494_160# net92 _114_/a_115_308# VGND sg13_lv_nmos ad=81.6f pd=0.895u as=0.1216p ps=1.02u w=0.64u l=0.13u
X30 _114_/a_358_436# net14 _114_/a_115_308# VPWR sg13_lv_pmos ad=0.2125p pd=1.425u as=0.35p ps=2.7u w=1u l=0.13u
X31 VPWR _114_/a_115_308# _005_ VPWR sg13_lv_pmos ad=0.3808p pd=2.92u as=0.3808p ps=2.92u w=1.12u l=0.13u
X32 VPWR dbit\[3\] hold41/a_56_118# VPWR sg13_lv_pmos ad=0 pd=0 as=0.90495p ps=8.44u w=0.42u l=0.13u
X33 VGND hold41/a_326_118# hold41/a_438_182# VGND sg13_lv_nmos ad=0 pd=0 as=0.867p ps=8.73u w=0.42u l=0.5u
X34 VPWR hold41/a_326_118# hold41/a_438_182# VPWR sg13_lv_pmos ad=0 pd=0 as=0 ps=0 w=1u l=0.5u
X35 net124 hold41/a_438_182# VPWR VPWR sg13_lv_pmos ad=1.17255p pd=9.565u as=0 ps=0 w=1.12u l=0.13u
X36 hold41/a_326_118# hold41/a_56_118# VPWR VPWR sg13_lv_pmos ad=0.86672p pd=7.46u as=0 ps=0 w=1u l=0.5u
X37 VGND dbit\[3\] hold41/a_56_118# VGND sg13_lv_nmos ad=0 pd=0 as=0 ps=0 w=0.42u l=0.13u
X38 net124 hold41/a_438_182# VGND VGND sg13_lv_nmos ad=0 pd=0 as=0 ps=0 w=0.74u l=0.13u
X39 hold41/a_326_118# hold41/a_56_118# VGND VGND sg13_lv_nmos ad=0 pd=0 as=0 ps=0 w=0.42u l=0.5u
X40 BN[2] output7/a_40_152# VGND VGND sg13_lv_nmos ad=0.70132p pd=6.065u as=0 ps=0 w=0.74u l=0.13u
X41 BN[2] output7/a_40_152# VPWR VPWR sg13_lv_pmos ad=0 pd=0 as=0 ps=0 w=1.12u l=0.13u
X42 VPWR net23 output7/a_40_152# VPWR sg13_lv_pmos ad=0 pd=0 as=0.75412p ps=7.7u w=0.84u l=0.13u
X43 VGND net23 output7/a_40_152# VGND sg13_lv_nmos ad=0 pd=0 as=0 ps=0 w=0.55u l=0.13u
X44 net78 BN\[1\]$_SDFFE_PP1P__62/a_222_366# VPWR VPWR sg13_lv_pmos ad=1.38742p pd=15.515u as=0 ps=0 w=1.155u l=0.13u
X45 VPWR BN\[1\]$_SDFFE_PP1P__62/a_23_195# BN\[1\]$_SDFFE_PP1P__62/a_23_429# VPWR sg13_lv_pmos ad=0 pd=0 as=0.41347p ps=4.16u w=0.66u l=0.13u
X46 BN\[1\]$_SDFFE_PP1P__62/a_222_366# BN\[1\]$_SDFFE_PP1P__62/a_23_429# VGND VGND sg13_lv_nmos ad=0.26675p pd=2.49u as=0 ps=0 w=0.795u l=0.13u
X47 VGND BN\[1\]$_SDFFE_PP1P__62/a_23_195# BN\[1\]$_SDFFE_PP1P__62/a_23_195# VGND sg13_lv_nmos ad=0 pd=0 as=0.1664p ps=1.8u w=0.3u l=0.13u
X48 D[2] output31/a_40_152# VGND VGND sg13_lv_nmos ad=0.70132p pd=6.065u as=0 ps=0 w=0.74u l=0.13u
X49 D[2] output31/a_40_152# VPWR VPWR sg13_lv_pmos ad=0 pd=0 as=0 ps=0 w=1.12u l=0.13u
X50 VPWR net47 output31/a_40_152# VPWR sg13_lv_pmos ad=0 pd=0 as=0.75412p ps=7.7u w=0.84u l=0.13u
X51 VGND net47 output31/a_40_152# VGND sg13_lv_nmos ad=0 pd=0 as=0 ps=0 w=0.55u l=0.13u
X52 B[3] output20/a_40_152# VGND VGND sg13_lv_nmos ad=0.70132p pd=6.065u as=0 ps=0 w=0.74u l=0.13u
X53 B[3] output20/a_40_152# VPWR VPWR sg13_lv_pmos ad=0 pd=0 as=0 ps=0 w=1.12u l=0.13u
X54 VPWR net36 output20/a_40_152# VPWR sg13_lv_pmos ad=0 pd=0 as=0.75412p ps=7.7u w=0.84u l=0.13u
X55 VGND net36 output20/a_40_152# VGND sg13_lv_nmos ad=0 pd=0 as=0 ps=0 w=0.55u l=0.13u
X56 net57 B\[7\]$_SDFFE_PP1P__41/a_222_366# VPWR VPWR sg13_lv_pmos ad=1.38742p pd=15.515u as=0 ps=0 w=1.155u l=0.13u
X57 VPWR B\[7\]$_SDFFE_PP1P__41/a_23_195# B\[7\]$_SDFFE_PP1P__41/a_23_429# VPWR sg13_lv_pmos ad=0 pd=0 as=0.41347p ps=4.16u w=0.66u l=0.13u
X58 B\[7\]$_SDFFE_PP1P__41/a_222_366# B\[7\]$_SDFFE_PP1P__41/a_23_429# VGND VGND sg13_lv_nmos ad=0.26675p pd=2.49u as=0 ps=0 w=0.795u l=0.13u
X59 VGND B\[7\]$_SDFFE_PP1P__41/a_23_195# B\[7\]$_SDFFE_PP1P__41/a_23_195# VGND sg13_lv_nmos ad=0 pd=0 as=0.1664p ps=1.8u w=0.3u l=0.13u
X60 VGND _130_/a_115_308# _012_ VGND sg13_lv_nmos ad=0 pd=0 as=1.16145p ps=9.205u w=0.74u l=0.13u
X61 VPWR net107 _130_/a_358_436# VPWR sg13_lv_pmos ad=0 pd=0 as=0.6318p ps=5.91u w=1u l=0.13u
X62 VGND _031_ _130_/a_494_160# VGND sg13_lv_nmos ad=0 pd=0 as=0 ps=0 w=0.64u l=0.13u
X63 _130_/a_358_436# _031_ VPWR VPWR sg13_lv_pmos ad=0 pd=0 as=0 ps=0 w=1u l=0.13u
X64 _130_/a_115_308# net12 VGND VGND sg13_lv_nmos ad=0.8714p pd=7.86u as=0 ps=0 w=0.64u l=0.13u
X65 _130_/a_494_160# net107 _130_/a_115_308# VGND sg13_lv_nmos ad=0 pd=0 as=0 ps=0 w=0.64u l=0.13u
X66 _130_/a_358_436# net12 _130_/a_115_308# VPWR sg13_lv_pmos ad=0 pd=0 as=0 ps=0 w=1u l=0.13u
X67 VPWR _130_/a_115_308# _012_ VPWR sg13_lv_pmos ad=0 pd=0 as=0 ps=0 w=1.12u l=0.13u
X68 VGND _050_ fanout8/a_27_118# VGND sg13_lv_nmos ad=0.1406p pd=1.12u as=0.1406p ps=1.12u w=0.74u l=0.13u M=3
X69 VPWR _050_ fanout8/a_27_118# VPWR sg13_lv_pmos ad=0.2128p pd=1.5u as=0.2128p ps=1.5u w=1.12u l=0.13u M=3
X70 net8 fanout8/a_27_118# VGND VGND sg13_lv_nmos ad=0.1406p pd=1.12u as=0.1406p ps=1.12u w=0.74u l=0.13u M=8
X71 net8 fanout8/a_27_118# VPWR VPWR sg13_lv_pmos ad=0.2128p pd=1.5u as=0.2128p ps=1.5u w=1.12u l=0.13u M=8
X72 _062_ net2 VPWR VPWR sg13_lv_pmos ad=0.2128p pd=1.5u as=0.3808p ps=2.92u w=1.12u l=0.13u
X73 VPWR net9 _062_ VPWR sg13_lv_pmos ad=0.2128p pd=1.5u as=0.2128p ps=1.5u w=1.12u l=0.13u
X74 _062_ net5 VPWR VPWR sg13_lv_pmos ad=0.2128p pd=1.5u as=0.2128p ps=1.5u w=1.12u l=0.13u
X75 VPWR net3 _062_ VPWR sg13_lv_pmos ad=0.3808p pd=2.92u as=0.2128p ps=1.5u w=1.12u l=0.13u
X76 _113_/a_146_122# net2 VGND VGND sg13_lv_nmos ad=0.1406p pd=1.12u as=0.2516p ps=2.16u w=0.74u l=0.13u
X77 _113_/a_248_122# net9 _113_/a_146_122# VGND sg13_lv_nmos ad=0.1406p pd=1.12u as=0.1406p ps=1.12u w=0.74u l=0.13u
X78 _113_/a_350_122# net5 _113_/a_248_122# VGND sg13_lv_nmos ad=0.1406p pd=1.12u as=0.1406p ps=1.12u w=0.74u l=0.13u
X79 _062_ net3 _113_/a_350_122# VGND sg13_lv_nmos ad=0.2516p pd=2.16u as=0.1406p ps=1.12u w=0.74u l=0.13u
X80 BN[5] output10/a_40_152# VGND VGND sg13_lv_nmos ad=0.70132p pd=6.065u as=0 ps=0 w=0.74u l=0.13u
X81 BN[5] output10/a_40_152# VPWR VPWR sg13_lv_pmos ad=0 pd=0 as=0 ps=0 w=1.12u l=0.13u
X82 VPWR net26 output10/a_40_152# VPWR sg13_lv_pmos ad=0 pd=0 as=0.75412p ps=7.7u w=0.84u l=0.13u
X83 VGND net26 output10/a_40_152# VGND sg13_lv_nmos ad=0 pd=0 as=0 ps=0 w=0.55u l=0.13u
X84 D[3] output32/a_40_152# VGND VGND sg13_lv_nmos ad=0.70132p pd=6.065u as=0 ps=0 w=0.74u l=0.13u
X85 D[3] output32/a_40_152# VPWR VPWR sg13_lv_pmos ad=0 pd=0 as=0 ps=0 w=1.12u l=0.13u
X86 VPWR net48 output32/a_40_152# VPWR sg13_lv_pmos ad=0 pd=0 as=0.75412p ps=7.7u w=0.84u l=0.13u
X87 VGND net48 output32/a_40_152# VGND sg13_lv_nmos ad=0 pd=0 as=0 ps=0 w=0.55u l=0.13u
X88 VPWR net38 hold20/a_56_118# VPWR sg13_lv_pmos ad=0 pd=0 as=0.90495p ps=8.44u w=0.42u l=0.13u
X89 VGND hold20/a_326_118# hold20/a_438_182# VGND sg13_lv_nmos ad=0 pd=0 as=0.867p ps=8.73u w=0.42u l=0.5u
X90 VPWR hold20/a_326_118# hold20/a_438_182# VPWR sg13_lv_pmos ad=0 pd=0 as=0 ps=0 w=1u l=0.5u
X91 net103 hold20/a_438_182# VPWR VPWR sg13_lv_pmos ad=1.0033p pd=7.815u as=0 ps=0 w=1.12u l=0.13u
X92 hold20/a_326_118# hold20/a_56_118# VPWR VPWR sg13_lv_pmos ad=0.86672p pd=7.46u as=0 ps=0 w=1u l=0.5u
X93 VGND net38 hold20/a_56_118# VGND sg13_lv_nmos ad=0 pd=0 as=0 ps=0 w=0.42u l=0.13u
X94 net103 hold20/a_438_182# VGND VGND sg13_lv_nmos ad=0 pd=0 as=0 ps=0 w=0.74u l=0.13u
X95 hold20/a_326_118# hold20/a_56_118# VGND VGND sg13_lv_nmos ad=0 pd=0 as=0 ps=0 w=0.42u l=0.5u
X96 VPWR net42 hold31/a_56_118# VPWR sg13_lv_pmos ad=0 pd=0 as=0.90495p ps=8.44u w=0.42u l=0.13u
X97 VGND hold31/a_326_118# hold31/a_438_182# VGND sg13_lv_nmos ad=0 pd=0 as=0.867p ps=8.73u w=0.42u l=0.5u
X98 VPWR hold31/a_326_118# hold31/a_438_182# VPWR sg13_lv_pmos ad=0 pd=0 as=0 ps=0 w=1u l=0.5u
X99 net114 hold31/a_438_182# VPWR VPWR sg13_lv_pmos ad=1.0117p pd=7.815u as=0 ps=0 w=1.12u l=0.13u
X100 hold31/a_326_118# hold31/a_56_118# VPWR VPWR sg13_lv_pmos ad=0.86672p pd=7.46u as=0 ps=0 w=1u l=0.5u
X101 VGND net42 hold31/a_56_118# VGND sg13_lv_nmos ad=0 pd=0 as=0 ps=0 w=0.42u l=0.13u
X102 net114 hold31/a_438_182# VGND VGND sg13_lv_nmos ad=0 pd=0 as=0 ps=0 w=0.74u l=0.13u
X103 hold31/a_326_118# hold31/a_56_118# VGND VGND sg13_lv_nmos ad=0 pd=0 as=0 ps=0 w=0.42u l=0.5u
X104 B[4] output21/a_40_152# VGND VGND sg13_lv_nmos ad=0.70132p pd=6.065u as=0 ps=0 w=0.74u l=0.13u
X105 B[4] output21/a_40_152# VPWR VPWR sg13_lv_pmos ad=0 pd=0 as=0 ps=0 w=1.12u l=0.13u
X106 VPWR net37 output21/a_40_152# VPWR sg13_lv_pmos ad=0 pd=0 as=0.75412p ps=7.7u w=0.84u l=0.13u
X107 VGND net37 output21/a_40_152# VGND sg13_lv_nmos ad=0 pd=0 as=0 ps=0 w=0.55u l=0.13u
X108 BN[3] output8/a_40_152# VGND VGND sg13_lv_nmos ad=0.70132p pd=6.065u as=0 ps=0 w=0.74u l=0.13u
X109 BN[3] output8/a_40_152# VPWR VPWR sg13_lv_pmos ad=0 pd=0 as=0 ps=0 w=1.12u l=0.13u
X110 VPWR net24 output8/a_40_152# VPWR sg13_lv_pmos ad=0 pd=0 as=0.75412p ps=7.7u w=0.84u l=0.13u
X111 VGND net24 output8/a_40_152# VGND sg13_lv_nmos ad=0 pd=0 as=0 ps=0 w=0.55u l=0.13u
X112 VPWR dbit\[0\] hold42/a_56_118# VPWR sg13_lv_pmos ad=0 pd=0 as=0.90495p ps=8.44u w=0.42u l=0.13u
X113 VGND hold42/a_326_118# hold42/a_438_182# VGND sg13_lv_nmos ad=0 pd=0 as=0.867p ps=8.73u w=0.42u l=0.5u
X114 VPWR hold42/a_326_118# hold42/a_438_182# VPWR sg13_lv_pmos ad=0 pd=0 as=0 ps=0 w=1u l=0.5u
X115 net125 hold42/a_438_182# VPWR VPWR sg13_lv_pmos ad=1.20627p pd=8.885u as=0 ps=0 w=1.12u l=0.13u
X116 hold42/a_326_118# hold42/a_56_118# VPWR VPWR sg13_lv_pmos ad=0.86672p pd=7.46u as=0 ps=0 w=1u l=0.5u
X117 VGND dbit\[0\] hold42/a_56_118# VGND sg13_lv_nmos ad=0 pd=0 as=0 ps=0 w=0.42u l=0.13u
X118 net125 hold42/a_438_182# VGND VGND sg13_lv_nmos ad=0 pd=0 as=0 ps=0 w=0.74u l=0.13u
X119 hold42/a_326_118# hold42/a_56_118# VGND VGND sg13_lv_nmos ad=0 pd=0 as=0 ps=0 w=0.42u l=0.5u
X120 VGND net64 BN\[8\]$_SDFFE_PP1P_/a_132_114# VGND sg13_lv_nmos ad=0.1626p pd=1.415u as=60.89999f ps=0.71u w=0.42u l=0.13u
X121 BN\[8\]$_SDFFE_PP1P_/a_550_127# net64 VGND VGND sg13_lv_nmos ad=37.8f pd=0.6u as=0.1701p ps=1.65u w=0.42u l=0.13u
X122 BN\[8\]$_SDFFE_PP1P_/a_298_337# BN\[8\]$_SDFFE_PP1P_/a_741_93# BN\[8\]$_SDFFE_PP1P_/a_681_505# VPWR sg13_lv_pmos ad=79.8f pd=0.8u as=63f ps=0.72u w=0.42u l=0.13u
X123 BN\[8\]$_SDFFE_PP1P_/a_1840_334# BN\[8\]$_SDFFE_PP1P_/a_1583_191# BN\[8\]$_SDFFE_PP1P_/a_2002_114# VGND sg13_lv_nmos ad=0.1428p pd=1.52u as=37.8f ps=0.6u w=0.42u l=0.13u
X124 BN\[8\]$_SDFFE_PP1P_/a_38_114# BN\[8\]$_SDFFE_PP1P_/a_843_236# BN\[8\]$_SDFFE_PP1P_/a_298_337# VPWR sg13_lv_pmos ad=0.1428p pd=1.52u as=79.8f ps=0.8u w=0.42u l=0.13u
X125 BN\[8\]$_SDFFE_PP1P_/a_741_93# clknet_2_0__leaf_clk VGND VGND sg13_lv_nmos ad=0.2516p pd=2.16u as=2.26778p ps=14.665u w=0.74u l=0.13u
X126 BN\[8\]$_SDFFE_PP1P_/a_38_114# net91 VPWR VPWR sg13_lv_pmos ad=79.8f pd=0.8u as=0.1428p ps=1.52u w=0.42u l=0.13u
X127 BN\[8\]$_SDFFE_PP1P_/a_741_93# clknet_2_0__leaf_clk VPWR VPWR sg13_lv_pmos ad=0.4088p pd=2.97u as=1.12285p ps=7.26u w=1.12u l=0.13u
X128 VGND BN\[8\]$_SDFFE_PP1P_/a_741_93# BN\[8\]$_SDFFE_PP1P_/a_843_236# VGND sg13_lv_nmos ad=2.26778p pd=14.665u as=0.2516p ps=2.16u w=0.74u l=0.13u
X129 VGND BN\[8\]$_SDFFE_PP1P_/a_1840_334# BN\[8\]$_SDFFE_PP1P_/a_1489_191# VGND sg13_lv_nmos ad=79.8f pd=0.8u as=0.1428p ps=1.52u w=0.42u l=0.13u
X130 VPWR net64 BN\[8\]$_SDFFE_PP1P_/a_38_114# VPWR sg13_lv_pmos ad=0.36237p pd=2.605u as=79.8f ps=0.8u w=0.42u l=0.13u
X131 BN\[8\]$_SDFFE_PP1P_/a_324_432# BN\[8\]$_SDFFE_PP1P_/a_298_337# VGND VGND sg13_lv_nmos ad=0.2516p pd=2.16u as=0.1626p ps=1.415u w=0.74u l=0.13u
X132 VPWR BN\[8\]$_SDFFE_PP1P_/a_741_93# BN\[8\]$_SDFFE_PP1P_/a_843_236# VPWR sg13_lv_pmos ad=1.12285p pd=7.26u as=0.3864p ps=2.93u w=1.12u l=0.13u
X133 BN\[8\]$_SDFFE_PP1P_/a_2002_114# net64 VGND VGND sg13_lv_nmos ad=37.8f pd=0.6u as=79.8f ps=0.8u w=0.42u l=0.13u
X134 VPWR BN\[8\]$_SDFFE_PP1P_/a_1583_191# BN\[8\]$_SDFFE_PP1P_/a_2250_412# VPWR sg13_lv_pmos ad=0.2128p pd=1.5u as=0.3864p ps=2.93u w=1.12u l=0.13u
X135 net29 BN\[8\]$_SDFFE_PP1P_/a_2250_412# VPWR VPWR sg13_lv_pmos ad=0.3808p pd=2.92u as=0.2128p ps=1.5u w=1.12u l=0.13u
X136 BN\[8\]$_SDFFE_PP1P_/a_132_114# net91 BN\[8\]$_SDFFE_PP1P_/a_38_114# VGND sg13_lv_nmos ad=60.89999f pd=0.71u as=0.1428p ps=1.52u w=0.42u l=0.13u
X137 BN\[8\]$_SDFFE_PP1P_/a_1785_429# BN\[8\]$_SDFFE_PP1P_/a_843_236# BN\[8\]$_SDFFE_PP1P_/a_1583_191# VPWR sg13_lv_pmos ad=93.45f pd=0.865u as=0.2048p ps=1.63u w=0.42u l=0.13u
X138 VPWR BN\[8\]$_SDFFE_PP1P_/a_1583_191# BN\[8\]$_SDFFE_PP1P_/a_1840_334# VPWR sg13_lv_pmos ad=1.12285p pd=7.26u as=79.8f ps=0.8u w=0.42u l=0.13u
X139 BN\[8\]$_SDFFE_PP1P_/a_1583_191# BN\[8\]$_SDFFE_PP1P_/a_741_93# BN\[8\]$_SDFFE_PP1P_/a_324_432# VPWR sg13_lv_pmos ad=0.2048p pd=1.63u as=0.34p ps=2.68u w=1u l=0.13u
X140 BN\[8\]$_SDFFE_PP1P_/a_1583_191# BN\[8\]$_SDFFE_PP1P_/a_741_93# BN\[8\]$_SDFFE_PP1P_/a_1489_191# VGND sg13_lv_nmos ad=0.12665p pd=1.145u as=0.1428p ps=1.52u w=0.42u l=0.13u
X141 VPWR BN\[8\]$_SDFFE_PP1P_/a_1840_334# BN\[8\]$_SDFFE_PP1P_/a_1785_429# VPWR sg13_lv_pmos ad=1.12285p pd=7.26u as=93.45f ps=0.865u w=0.42u l=0.13u
X142 BN\[8\]$_SDFFE_PP1P_/a_1840_334# net64 VPWR VPWR sg13_lv_pmos ad=79.8f pd=0.8u as=1.12285p ps=7.26u w=0.42u l=0.13u
X143 BN\[8\]$_SDFFE_PP1P_/a_324_432# BN\[8\]$_SDFFE_PP1P_/a_843_236# BN\[8\]$_SDFFE_PP1P_/a_1583_191# VGND sg13_lv_nmos ad=0.3473p pd=2.71u as=0.12665p ps=1.145u w=0.74u l=0.13u
X144 BN\[8\]$_SDFFE_PP1P_/a_298_337# BN\[8\]$_SDFFE_PP1P_/a_741_93# BN\[8\]$_SDFFE_PP1P_/a_38_114# VGND sg13_lv_nmos ad=79.8f pd=0.8u as=0.1296p ps=1.52u w=0.42u l=0.13u
X145 BN\[8\]$_SDFFE_PP1P_/a_612_127# BN\[8\]$_SDFFE_PP1P_/a_324_432# BN\[8\]$_SDFFE_PP1P_/a_550_127# VGND sg13_lv_nmos ad=0.1428p pd=1.52u as=37.8f ps=0.6u w=0.42u l=0.13u
X146 BN\[8\]$_SDFFE_PP1P_/a_681_505# BN\[8\]$_SDFFE_PP1P_/a_324_432# VPWR VPWR sg13_lv_pmos ad=63f pd=0.72u as=0.1563p ps=1.22u w=0.42u l=0.13u
X147 BN\[8\]$_SDFFE_PP1P_/a_612_127# BN\[8\]$_SDFFE_PP1P_/a_843_236# BN\[8\]$_SDFFE_PP1P_/a_298_337# VGND sg13_lv_nmos ad=0.2373p pd=1.97u as=79.8f ps=0.8u w=0.42u l=0.13u
X148 VGND BN\[8\]$_SDFFE_PP1P_/a_1583_191# BN\[8\]$_SDFFE_PP1P_/a_2250_412# VGND sg13_lv_nmos ad=0.1406p pd=1.12u as=0.2516p ps=2.16u w=0.74u l=0.13u
X149 BN\[8\]$_SDFFE_PP1P_/a_324_432# BN\[8\]$_SDFFE_PP1P_/a_298_337# VPWR VPWR sg13_lv_pmos ad=0.34p pd=2.68u as=0.36237p ps=2.605u w=1u l=0.13u
X150 net29 BN\[8\]$_SDFFE_PP1P_/a_2250_412# VGND VGND sg13_lv_nmos ad=0.2516p pd=2.16u as=0.1406p ps=1.12u w=0.74u l=0.13u
X151 VPWR net64 BN\[8\]$_SDFFE_PP1P_/a_298_337# VPWR sg13_lv_pmos ad=0.1563p pd=1.22u as=0.147p ps=1.54u w=0.42u l=0.13u
X152 net77 B\[2\]$_SDFFE_PP1P__61/a_222_366# VPWR VPWR sg13_lv_pmos ad=1.38742p pd=15.515u as=0 ps=0 w=1.155u l=0.13u
X153 VPWR B\[2\]$_SDFFE_PP1P__61/a_23_195# B\[2\]$_SDFFE_PP1P__61/a_23_429# VPWR sg13_lv_pmos ad=0 pd=0 as=0.41347p ps=4.16u w=0.66u l=0.13u
X154 B\[2\]$_SDFFE_PP1P__61/a_222_366# B\[2\]$_SDFFE_PP1P__61/a_23_429# VGND VGND sg13_lv_nmos ad=0.26675p pd=2.49u as=0 ps=0 w=0.795u l=0.13u
X155 VGND B\[2\]$_SDFFE_PP1P__61/a_23_195# B\[2\]$_SDFFE_PP1P__61/a_23_195# VGND sg13_lv_nmos ad=0 pd=0 as=0.1664p ps=1.8u w=0.3u l=0.13u
X156 VPWR _023_ hold32/a_56_118# VPWR sg13_lv_pmos ad=0 pd=0 as=0.90495p ps=8.44u w=0.42u l=0.13u
X157 VGND hold32/a_326_118# hold32/a_438_182# VGND sg13_lv_nmos ad=0 pd=0 as=0.867p ps=8.73u w=0.42u l=0.5u
X158 VPWR hold32/a_326_118# hold32/a_438_182# VPWR sg13_lv_pmos ad=0 pd=0 as=0 ps=0 w=1u l=0.5u
X159 net115 hold32/a_438_182# VPWR VPWR sg13_lv_pmos ad=1.16637p pd=8.745u as=0 ps=0 w=1.12u l=0.13u
X160 hold32/a_326_118# hold32/a_56_118# VPWR VPWR sg13_lv_pmos ad=0.86672p pd=7.46u as=0 ps=0 w=1u l=0.5u
X161 VGND _023_ hold32/a_56_118# VGND sg13_lv_nmos ad=0 pd=0 as=0 ps=0 w=0.42u l=0.13u
X162 net115 hold32/a_438_182# VGND VGND sg13_lv_nmos ad=0 pd=0 as=0 ps=0 w=0.74u l=0.13u
X163 hold32/a_326_118# hold32/a_56_118# VGND VGND sg13_lv_nmos ad=0 pd=0 as=0 ps=0 w=0.42u l=0.5u
X164 VPWR net10 hold43/a_56_118# VPWR sg13_lv_pmos ad=0 pd=0 as=0.90495p ps=8.44u w=0.42u l=0.13u
X165 VGND hold43/a_326_118# hold43/a_438_182# VGND sg13_lv_nmos ad=0 pd=0 as=0.867p ps=8.73u w=0.42u l=0.5u
X166 VPWR hold43/a_326_118# hold43/a_438_182# VPWR sg13_lv_pmos ad=0 pd=0 as=0 ps=0 w=1u l=0.5u
X167 net126 hold43/a_438_182# VPWR VPWR sg13_lv_pmos ad=1.21642p pd=8.955u as=0 ps=0 w=1.12u l=0.13u
X168 hold43/a_326_118# hold43/a_56_118# VPWR VPWR sg13_lv_pmos ad=0.86672p pd=7.46u as=0 ps=0 w=1u l=0.5u
X169 VGND net10 hold43/a_56_118# VGND sg13_lv_nmos ad=0 pd=0 as=0 ps=0 w=0.42u l=0.13u
X170 net126 hold43/a_438_182# VGND VGND sg13_lv_nmos ad=0 pd=0 as=0 ps=0 w=0.74u l=0.13u
X171 hold43/a_326_118# hold43/a_56_118# VGND VGND sg13_lv_nmos ad=0 pd=0 as=0 ps=0 w=0.42u l=0.5u
X172 VPWR _019_ hold21/a_56_118# VPWR sg13_lv_pmos ad=0 pd=0 as=0.90495p ps=8.44u w=0.42u l=0.13u
X173 VGND hold21/a_326_118# hold21/a_438_182# VGND sg13_lv_nmos ad=0 pd=0 as=0.867p ps=8.73u w=0.42u l=0.5u
X174 VPWR hold21/a_326_118# hold21/a_438_182# VPWR sg13_lv_pmos ad=0 pd=0 as=0 ps=0 w=1u l=0.5u
X175 net104 hold21/a_438_182# VPWR VPWR sg13_lv_pmos ad=1.14608p pd=8.605u as=0 ps=0 w=1.12u l=0.13u
X176 hold21/a_326_118# hold21/a_56_118# VPWR VPWR sg13_lv_pmos ad=0.86672p pd=7.46u as=0 ps=0 w=1u l=0.5u
X177 VGND _019_ hold21/a_56_118# VGND sg13_lv_nmos ad=0 pd=0 as=0 ps=0 w=0.42u l=0.13u
X178 net104 hold21/a_438_182# VGND VGND sg13_lv_nmos ad=0 pd=0 as=0 ps=0 w=0.74u l=0.13u
X179 hold21/a_326_118# hold21/a_56_118# VGND VGND sg13_lv_nmos ad=0 pd=0 as=0 ps=0 w=0.42u l=0.5u
X180 VGND _112_/a_115_308# _004_ VGND sg13_lv_nmos ad=0 pd=0 as=1.16145p ps=9.205u w=0.74u l=0.13u
X181 VPWR net86 _112_/a_358_436# VPWR sg13_lv_pmos ad=0 pd=0 as=0.6318p ps=5.91u w=1u l=0.13u
X182 VGND _061_ _112_/a_494_160# VGND sg13_lv_nmos ad=0 pd=0 as=0 ps=0 w=0.64u l=0.13u
X183 _112_/a_358_436# _061_ VPWR VPWR sg13_lv_pmos ad=0 pd=0 as=0 ps=0 w=1u l=0.13u
X184 _112_/a_115_308# net14 VGND VGND sg13_lv_nmos ad=0.8714p pd=7.86u as=0 ps=0 w=0.64u l=0.13u
X185 _112_/a_494_160# net86 _112_/a_115_308# VGND sg13_lv_nmos ad=0 pd=0 as=0 ps=0 w=0.64u l=0.13u
X186 _112_/a_358_436# net14 _112_/a_115_308# VPWR sg13_lv_pmos ad=0 pd=0 as=0 ps=0 w=1u l=0.13u
X187 VPWR _112_/a_115_308# _004_ VPWR sg13_lv_pmos ad=0 pd=0 as=0 ps=0 w=1.12u l=0.13u
X188 VPWR _005_ hold10/a_56_118# VPWR sg13_lv_pmos ad=0 pd=0 as=0.90495p ps=8.44u w=0.42u l=0.13u
X189 VGND hold10/a_326_118# hold10/a_438_182# VGND sg13_lv_nmos ad=0 pd=0 as=0.867p ps=8.73u w=0.42u l=0.5u
X190 VPWR hold10/a_326_118# hold10/a_438_182# VPWR sg13_lv_pmos ad=0 pd=0 as=0 ps=0 w=1u l=0.5u
X191 net93 hold10/a_438_182# VPWR VPWR sg13_lv_pmos ad=1.14608p pd=8.605u as=0 ps=0 w=1.12u l=0.13u
X192 hold10/a_326_118# hold10/a_56_118# VPWR VPWR sg13_lv_pmos ad=0.86672p pd=7.46u as=0 ps=0 w=1u l=0.5u
X193 VGND _005_ hold10/a_56_118# VGND sg13_lv_nmos ad=0 pd=0 as=0 ps=0 w=0.42u l=0.13u
X194 net93 hold10/a_438_182# VGND VGND sg13_lv_nmos ad=0 pd=0 as=0 ps=0 w=0.74u l=0.13u
X195 hold10/a_326_118# hold10/a_56_118# VGND VGND sg13_lv_nmos ad=0 pd=0 as=0 ps=0 w=0.42u l=0.5u
X196 net9 fanout9/a_40_152# VGND VGND sg13_lv_nmos ad=1.24732p pd=11.985u as=0 ps=0 w=0.74u l=0.13u
X197 net9 fanout9/a_40_152# VPWR VPWR sg13_lv_pmos ad=0 pd=0 as=0 ps=0 w=1.12u l=0.13u
X198 VPWR _050_ fanout9/a_40_152# VPWR sg13_lv_pmos ad=0 pd=0 as=0.75412p ps=7.7u w=0.84u l=0.13u
X199 VGND _050_ fanout9/a_40_152# VGND sg13_lv_nmos ad=0 pd=0 as=0 ps=0 w=0.55u l=0.13u
X200 VGND net75 dbit\[3\]$_SDFFE_PP1P_/a_132_114# VGND sg13_lv_nmos ad=0.1626p pd=1.415u as=60.89999f ps=0.71u w=0.42u l=0.13u
X201 VPWR dbit\[3\]$_SDFFE_PP1P_/a_1583_191# dbit\[3\]$_SDFFE_PP1P_/a_1811_331# VPWR sg13_lv_pmos ad=0.9956p pd=6.25u as=79.8f ps=0.8u w=0.42u l=0.13u
X202 VGND dbit\[3\]$_SDFFE_PP1P_/a_733_371# dbit\[3\]$_SDFFE_PP1P_/a_835_458# VGND sg13_lv_nmos ad=2.45365p pd=15.675u as=0.2516p ps=2.16u w=0.74u l=0.13u
X203 dbit\[3\]$_SDFFE_PP1P_/a_733_371# clknet_2_1__leaf_clk VPWR VPWR sg13_lv_pmos ad=0.3808p pd=2.92u as=1.19473p ps=7.5u w=1.12u l=0.13u
X204 dbit\[3\]$_SDFFE_PP1P_/a_550_127# net75 VGND VGND sg13_lv_nmos ad=38.85f pd=0.605u as=0.1701p ps=1.65u w=0.42u l=0.13u
X205 dbit\[3\]$_SDFFE_PP1P_/a_613_127# dbit\[3\]$_SDFFE_PP1P_/a_324_432# dbit\[3\]$_SDFFE_PP1P_/a_550_127# VGND sg13_lv_nmos ad=0.1596p pd=1.6u as=38.85f ps=0.605u w=0.42u l=0.13u
X206 dbit\[3\]$_SDFFE_PP1P_/a_2186_429# dbit\[3\]$_SDFFE_PP1P_/a_1583_191# VPWR VPWR sg13_lv_pmos ad=0.34p pd=2.68u as=0.9956p ps=6.25u w=1u l=0.13u
X207 dbit\[3\]$_SDFFE_PP1P_/a_1811_331# dbit\[3\]$_SDFFE_PP1P_/a_1583_191# dbit\[3\]$_SDFFE_PP1P_/a_2002_114# VGND sg13_lv_nmos ad=0.1428p pd=1.52u as=37.8f ps=0.6u w=0.42u l=0.13u
X208 dbit\[3\]$_SDFFE_PP1P_/a_1772_429# dbit\[3\]$_SDFFE_PP1P_/a_835_458# dbit\[3\]$_SDFFE_PP1P_/a_1583_191# VPWR sg13_lv_pmos ad=52.5f pd=0.67u as=0.19115p ps=1.565u w=0.42u l=0.13u
X209 dbit\[3\]$_SDFFE_PP1P_/a_733_371# clknet_2_1__leaf_clk VGND VGND sg13_lv_nmos ad=0.2516p pd=2.16u as=2.45365p ps=15.675u w=0.74u l=0.13u
X210 dbit\[3\]$_SDFFE_PP1P_/a_38_114# _027_ VPWR VPWR sg13_lv_pmos ad=79.8f pd=0.8u as=0.1428p ps=1.52u w=0.42u l=0.13u
X211 dbit\[3\]$_SDFFE_PP1P_/a_1811_331# net75 VPWR VPWR sg13_lv_pmos ad=79.8f pd=0.8u as=1.19473p ps=7.5u w=0.42u l=0.13u
X212 VGND dbit\[3\]$_SDFFE_PP1P_/a_1811_331# dbit\[3\]$_SDFFE_PP1P_/a_1489_191# VGND sg13_lv_nmos ad=79.8f pd=0.8u as=0.1428p ps=1.52u w=0.42u l=0.13u
X213 VGND dbit\[3\]$_SDFFE_PP1P_/a_2186_429# dbit\[3\] VGND sg13_lv_nmos ad=0.2516p pd=2.16u as=0.14245p ps=1.125u w=0.74u l=0.13u M=2
X214 VPWR net75 dbit\[3\]$_SDFFE_PP1P_/a_38_114# VPWR sg13_lv_pmos ad=0.36237p pd=2.605u as=79.8f ps=0.8u w=0.42u l=0.13u
X215 dbit\[3\]$_SDFFE_PP1P_/a_324_432# dbit\[3\]$_SDFFE_PP1P_/a_298_337# VGND VGND sg13_lv_nmos ad=0.2516p pd=2.16u as=0.1626p ps=1.415u w=0.74u l=0.13u
X216 VPWR dbit\[3\]$_SDFFE_PP1P_/a_733_371# dbit\[3\]$_SDFFE_PP1P_/a_835_458# VPWR sg13_lv_pmos ad=1.19473p pd=7.5u as=0.3864p ps=2.93u w=1.12u l=0.13u
X217 dbit\[3\]$_SDFFE_PP1P_/a_2002_114# net75 VGND VGND sg13_lv_nmos ad=37.8f pd=0.6u as=79.8f ps=0.8u w=0.42u l=0.13u
X218 dbit\[3\]$_SDFFE_PP1P_/a_132_114# _027_ dbit\[3\]$_SDFFE_PP1P_/a_38_114# VGND sg13_lv_nmos ad=60.89999f pd=0.71u as=0.1428p ps=1.52u w=0.42u l=0.13u
X219 dbit\[3\] dbit\[3\]$_SDFFE_PP1P_/a_2186_429# VPWR VPWR sg13_lv_pmos ad=0.2156p pd=1.505u as=0.3808p ps=2.92u w=1.12u l=0.13u M=2
X220 dbit\[3\]$_SDFFE_PP1P_/a_2186_429# dbit\[3\]$_SDFFE_PP1P_/a_1583_191# VGND VGND sg13_lv_nmos ad=0.2176p pd=1.96u as=0.2176p ps=1.96u w=0.64u l=0.13u
X221 dbit\[3\]$_SDFFE_PP1P_/a_1583_191# dbit\[3\]$_SDFFE_PP1P_/a_733_371# dbit\[3\]$_SDFFE_PP1P_/a_324_432# VPWR sg13_lv_pmos ad=0.19115p pd=1.565u as=0.34p ps=2.68u w=1u l=0.13u
X222 VPWR dbit\[3\]$_SDFFE_PP1P_/a_1811_331# dbit\[3\]$_SDFFE_PP1P_/a_1772_429# VPWR sg13_lv_pmos ad=1.19473p pd=7.5u as=52.5f ps=0.67u w=0.42u l=0.13u
X223 dbit\[3\]$_SDFFE_PP1P_/a_1583_191# dbit\[3\]$_SDFFE_PP1P_/a_733_371# dbit\[3\]$_SDFFE_PP1P_/a_1489_191# VGND sg13_lv_nmos ad=0.12665p pd=1.145u as=0.1428p ps=1.52u w=0.42u l=0.13u
X224 dbit\[3\]$_SDFFE_PP1P_/a_298_337# dbit\[3\]$_SDFFE_PP1P_/a_733_371# dbit\[3\]$_SDFFE_PP1P_/a_681_505# VPWR sg13_lv_pmos ad=79.8f pd=0.8u as=54.6f ps=0.68u w=0.42u l=0.13u
X225 dbit\[3\]$_SDFFE_PP1P_/a_38_114# dbit\[3\]$_SDFFE_PP1P_/a_835_458# dbit\[3\]$_SDFFE_PP1P_/a_298_337# VPWR sg13_lv_pmos ad=0.1428p pd=1.52u as=79.8f ps=0.8u w=0.42u l=0.13u
X226 dbit\[3\]$_SDFFE_PP1P_/a_324_432# dbit\[3\]$_SDFFE_PP1P_/a_835_458# dbit\[3\]$_SDFFE_PP1P_/a_1583_191# VGND sg13_lv_nmos ad=0.3473p pd=2.71u as=0.12665p ps=1.145u w=0.74u l=0.13u
X227 dbit\[3\]$_SDFFE_PP1P_/a_298_337# dbit\[3\]$_SDFFE_PP1P_/a_733_371# dbit\[3\]$_SDFFE_PP1P_/a_38_114# VGND sg13_lv_nmos ad=81f pd=0.81u as=0.1296p ps=1.52u w=0.42u l=0.13u
X228 dbit\[3\]$_SDFFE_PP1P_/a_681_505# dbit\[3\]$_SDFFE_PP1P_/a_324_432# VPWR VPWR sg13_lv_pmos ad=54.6f pd=0.68u as=0.1563p ps=1.22u w=0.42u l=0.13u
X229 dbit\[3\]$_SDFFE_PP1P_/a_613_127# dbit\[3\]$_SDFFE_PP1P_/a_835_458# dbit\[3\]$_SDFFE_PP1P_/a_298_337# VGND sg13_lv_nmos ad=0.2163p pd=1.87u as=81f ps=0.81u w=0.42u l=0.13u
X230 dbit\[3\]$_SDFFE_PP1P_/a_324_432# dbit\[3\]$_SDFFE_PP1P_/a_298_337# VPWR VPWR sg13_lv_pmos ad=0.34p pd=2.68u as=0.36237p ps=2.605u w=1u l=0.13u
X231 VPWR net75 dbit\[3\]$_SDFFE_PP1P_/a_298_337# VPWR sg13_lv_pmos ad=0.1563p pd=1.22u as=0.147p ps=1.54u w=0.42u l=0.13u
X232 B[5] output22/a_40_152# VGND VGND sg13_lv_nmos ad=0.70132p pd=6.065u as=0 ps=0 w=0.74u l=0.13u
X233 B[5] output22/a_40_152# VPWR VPWR sg13_lv_pmos ad=0 pd=0 as=0 ps=0 w=1.12u l=0.13u
X234 VPWR net38 output22/a_40_152# VPWR sg13_lv_pmos ad=0 pd=0 as=0.75412p ps=7.7u w=0.84u l=0.13u
X235 VGND net38 output22/a_40_152# VGND sg13_lv_nmos ad=0 pd=0 as=0 ps=0 w=0.55u l=0.13u
X236 BN[6] output11/a_40_152# VGND VGND sg13_lv_nmos ad=0.70132p pd=6.065u as=0 ps=0 w=0.74u l=0.13u
X237 BN[6] output11/a_40_152# VPWR VPWR sg13_lv_pmos ad=0 pd=0 as=0 ps=0 w=1.12u l=0.13u
X238 VPWR net27 output11/a_40_152# VPWR sg13_lv_pmos ad=0 pd=0 as=0.75412p ps=7.7u w=0.84u l=0.13u
X239 VGND net27 output11/a_40_152# VGND sg13_lv_nmos ad=0 pd=0 as=0 ps=0 w=0.55u l=0.13u
X240 BN[4] output9/a_40_152# VGND VGND sg13_lv_nmos ad=0.70132p pd=6.065u as=0 ps=0 w=0.74u l=0.13u
X241 BN[4] output9/a_40_152# VPWR VPWR sg13_lv_pmos ad=0 pd=0 as=0 ps=0 w=1.12u l=0.13u
X242 VPWR net25 output9/a_40_152# VPWR sg13_lv_pmos ad=0 pd=0 as=0.75412p ps=7.7u w=0.84u l=0.13u
X243 VGND net25 output9/a_40_152# VGND sg13_lv_nmos ad=0 pd=0 as=0 ps=0 w=0.55u l=0.13u
X244 D[4] output33/a_40_152# VGND VGND sg13_lv_nmos ad=0.70132p pd=6.065u as=0 ps=0 w=0.74u l=0.13u
X245 D[4] output33/a_40_152# VPWR VPWR sg13_lv_pmos ad=0 pd=0 as=0 ps=0 w=1.12u l=0.13u
X246 VPWR net49 output33/a_40_152# VPWR sg13_lv_pmos ad=0 pd=0 as=0.75412p ps=7.7u w=0.84u l=0.13u
X247 VGND net49 output33/a_40_152# VGND sg13_lv_nmos ad=0 pd=0 as=0 ps=0 w=0.55u l=0.13u
X248 _061_ _055_ VPWR VPWR sg13_lv_pmos ad=1.26528p pd=12.155u as=0 ps=0 w=1.12u l=0.13u
X249 VPWR net2 _061_ VPWR sg13_lv_pmos ad=0 pd=0 as=0 ps=0 w=1.12u l=0.13u
X250 _061_ net9 VPWR VPWR sg13_lv_pmos ad=0 pd=0 as=0 ps=0 w=1.12u l=0.13u
X251 _111_/a_146_122# _055_ VGND VGND sg13_lv_nmos ad=0 pd=0 as=0 ps=0 w=0.74u l=0.13u
X252 _111_/a_248_122# net2 _111_/a_146_122# VGND sg13_lv_nmos ad=0 pd=0 as=0 ps=0 w=0.74u l=0.13u
X253 _061_ net9 _111_/a_248_122# VGND sg13_lv_nmos ad=0 pd=0 as=0 ps=0 w=0.74u l=0.13u
X254 B[6] output23/a_40_152# VGND VGND sg13_lv_nmos ad=0.70132p pd=6.065u as=0 ps=0 w=0.74u l=0.13u
X255 B[6] output23/a_40_152# VPWR VPWR sg13_lv_pmos ad=0 pd=0 as=0 ps=0 w=1.12u l=0.13u
X256 VPWR net39 output23/a_40_152# VPWR sg13_lv_pmos ad=0 pd=0 as=0.75412p ps=7.7u w=0.84u l=0.13u
X257 VGND net39 output23/a_40_152# VGND sg13_lv_nmos ad=0 pd=0 as=0 ps=0 w=0.55u l=0.13u
X258 VPWR net39 hold33/a_56_118# VPWR sg13_lv_pmos ad=0 pd=0 as=0.90495p ps=8.44u w=0.42u l=0.13u
X259 VGND hold33/a_326_118# hold33/a_438_182# VGND sg13_lv_nmos ad=0 pd=0 as=0.867p ps=8.73u w=0.42u l=0.5u
X260 VPWR hold33/a_326_118# hold33/a_438_182# VPWR sg13_lv_pmos ad=0 pd=0 as=0 ps=0 w=1u l=0.5u
X261 net116 hold33/a_438_182# VPWR VPWR sg13_lv_pmos ad=1.0033p pd=7.815u as=0 ps=0 w=1.12u l=0.13u
X262 hold33/a_326_118# hold33/a_56_118# VPWR VPWR sg13_lv_pmos ad=0.86672p pd=7.46u as=0 ps=0 w=1u l=0.5u
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
