Fawad149/SAR-ADC-sg13g2/digital/librelane/runs/RUN_FINAL/32-openroad-repairdesignpostgpl/sar_logic.pnl.v

module sar_logic (Om,
    Op,
    clk,
    rst,
    sign,
    VPWR,
    VGND,
    B,
    BN,
    D);
 input Om;
 input Op;
 input clk;
 input rst;
 output sign;
 inout VPWR;
 inout VGND;
 output [11:0] B;
 output [11:0] BN;
 output [11:0] D;

 wire net19;
 wire net20;
 wire net21;
 wire net22;
 wire net23;
 wire net24;
 wire net25;
 wire net26;
 wire net27;
 wire net28;
 wire net29;
 wire net30;
 wire net31;
 wire net32;
 wire net33;
 wire net34;
 wire net35;
 wire net36;
 wire net37;
 wire net38;
 wire net39;
 wire net40;
 wire net41;
 wire net42;
 wire net43;
 wire net44;
 wire net45;
 wire net46;
 wire net47;
 wire net48;
 wire net49;
 wire net50;
 wire net51;
 wire net52;
 wire net53;
 wire net54;
 wire _000_;
 wire _001_;
 wire _002_;
 wire _003_;
 wire _004_;
 wire _005_;
 wire _006_;
 wire _007_;
 wire _008_;
 wire _009_;
 wire _010_;
 wire _011_;
 wire _012_;
 wire _013_;
 wire _014_;
 wire _015_;
 wire _016_;
 wire _017_;
 wire _018_;
 wire _019_;
 wire _020_;
 wire _021_;
 wire _022_;
 wire _023_;
 wire _024_;
 wire _025_;
 wire _026_;
 wire _027_;
 wire _028_;
 wire _029_;
 wire _030_;
 wire _031_;
 wire _032_;
 wire _033_;
 wire _034_;
 wire _035_;
 wire _036_;
 wire _037_;
 wire _038_;
 wire _039_;
 wire _040_;
 wire _041_;
 wire _042_;
 wire _043_;
 wire _044_;
 wire _045_;
 wire _046_;
 wire _047_;
 wire _048_;
 wire _049_;
 wire _050_;
 wire _051_;
 wire _052_;
 wire _053_;
 wire _054_;
 wire _055_;
 wire _056_;
 wire _057_;
 wire _058_;
 wire _059_;
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
    .VDD(VPWR),
    .VSS(VGND));
 sg13g2_buf_1 output38 (.A(net54),
    .X(D[9]),
    .VDD(VPWR),
    .VSS(VGND));
 sg13g2_buf_1 output39 (.A(net55),
    .X(sign),
    .VDD(VPWR),
    .VSS(VGND));
 sg13g2_tiehi \B[11]$_SDFFE_PP1P__40  (.VDD(VPWR),
    .VSS(VGND),
    .L_HI(net56));
endmodule
